luk6xff/led-clock/README.md

# led-clock
LED clock with some fancy features.

## Details
The clock is configurable over web inteface. The time is provided by extremaly accurate RTC DS3231. It can be also synchronized with NTP server.
It receives and display meteo data from external LORA sensor.
You can also configure [openweather map API](https://openweathermap.org/) to get and display latest weather forecast for your city.
The clock UI supports two languages currently: polish and english.
You can check below the videos to see how it works in action:

* video1 (https://www.youtube.com/watch?v=KoFvoKO0Jg0)
* video1 (https://www.youtube.com/watch?v=WqVvntWIiOE)

## Some pics
### Device
* Printed Case:
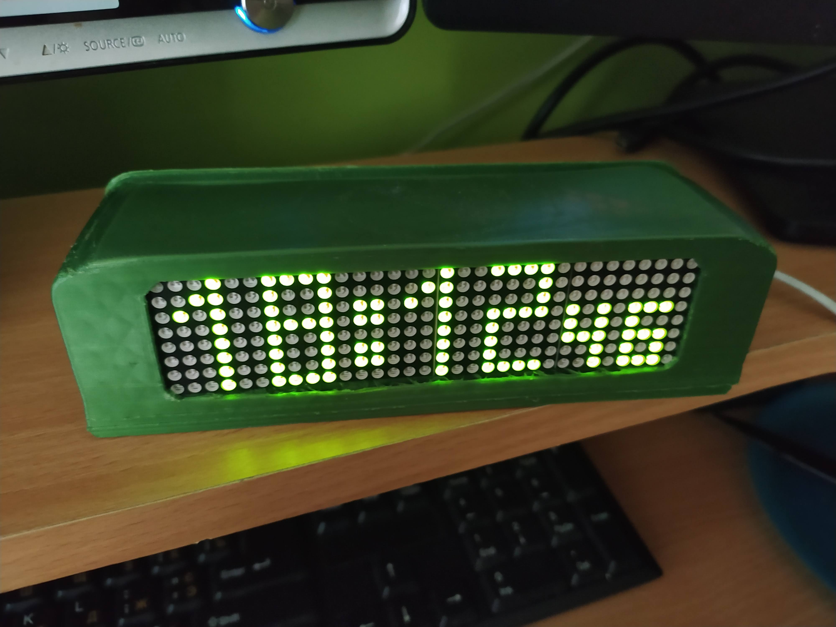
[picture p1: docs/pics/dev-case1.jpg]

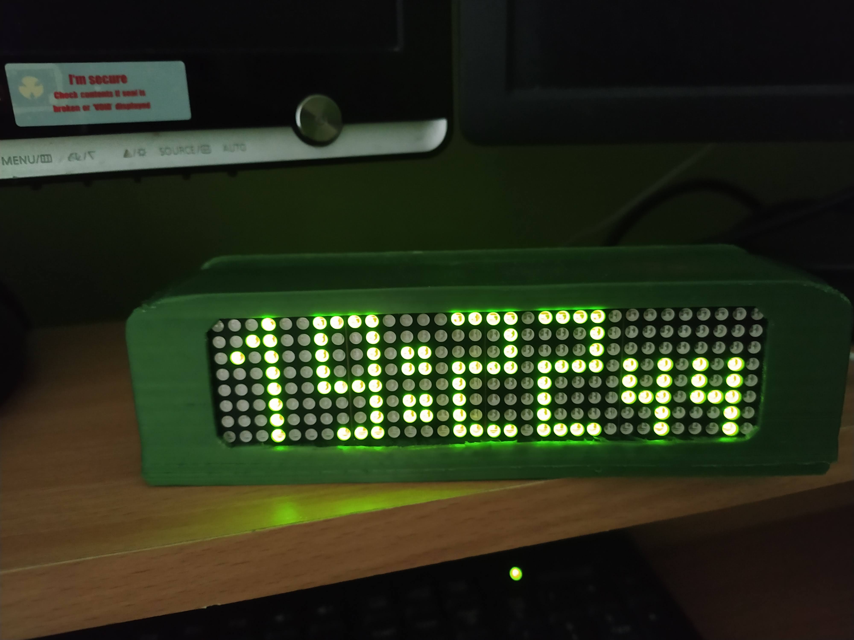
[picture p2: docs/pics/dev-case2.jpg]

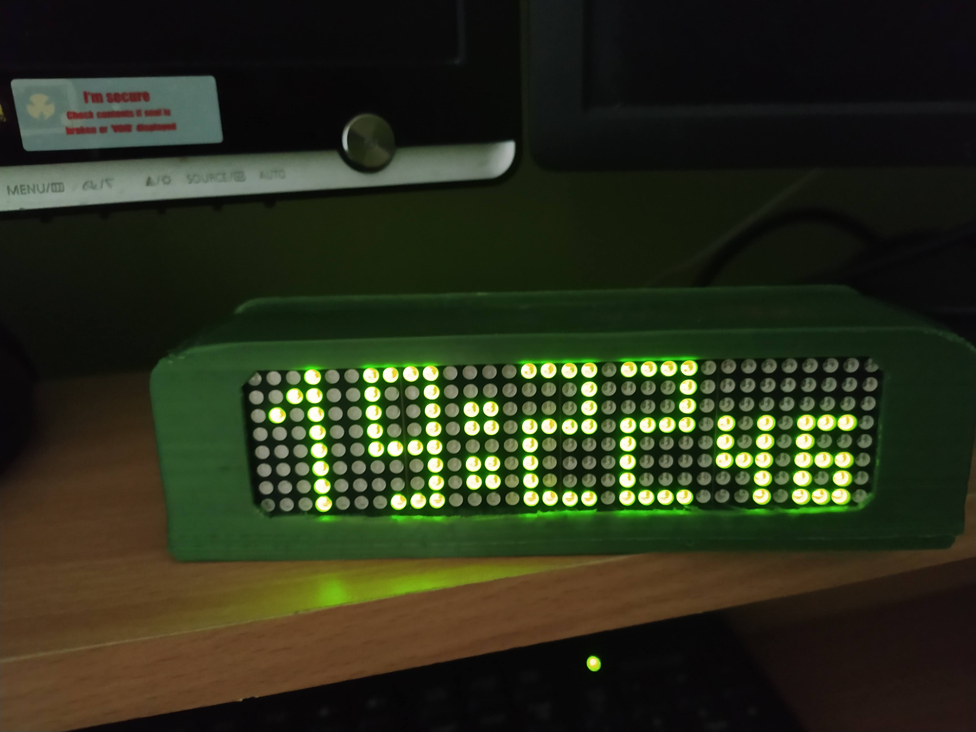
[picture p3: docs/pics/dev-case3.jpg]

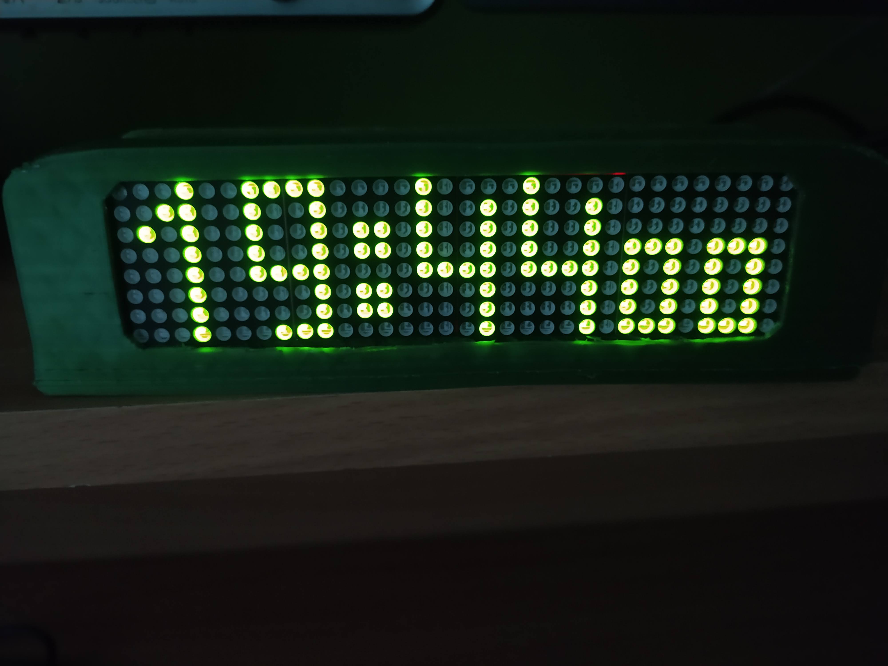
[picture p4: docs/pics/dev-case4.jpg]


* LoRa meteo sensor:

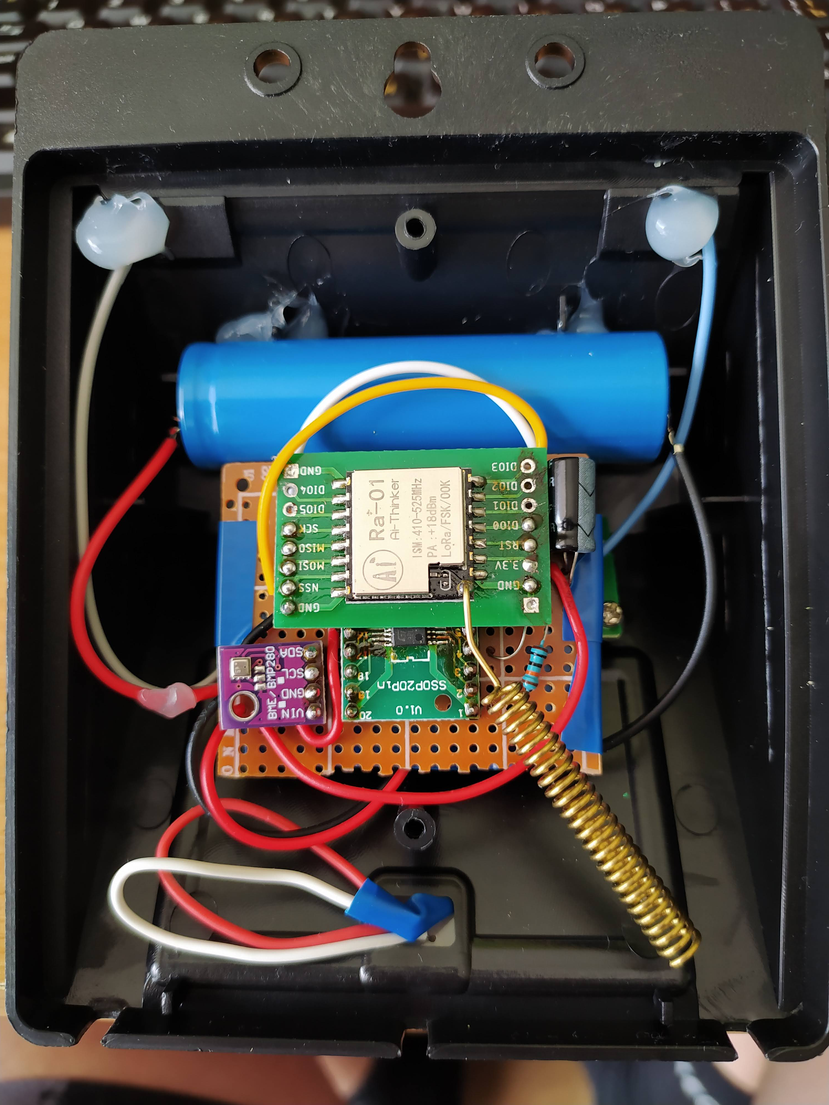
[picture p6: docs/pics/dev-sensor12.jpg]

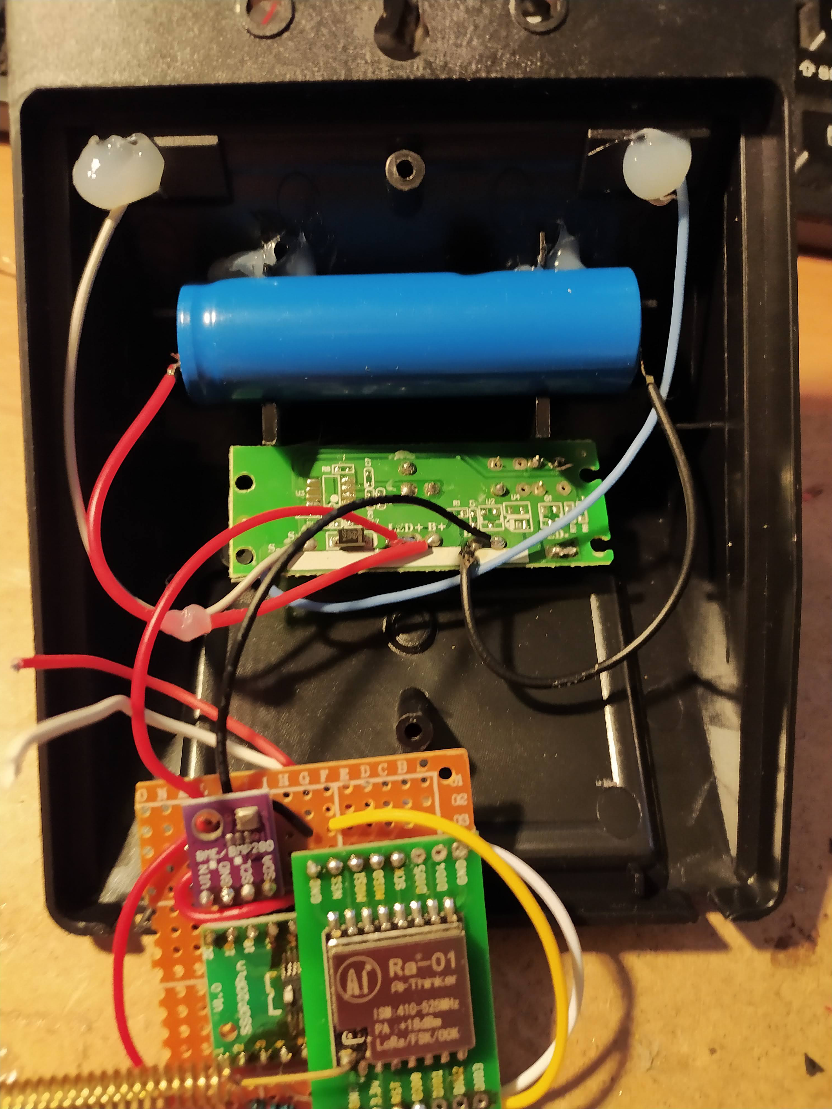
[picture p7: docs/pics/dev-sensor11.jpg]

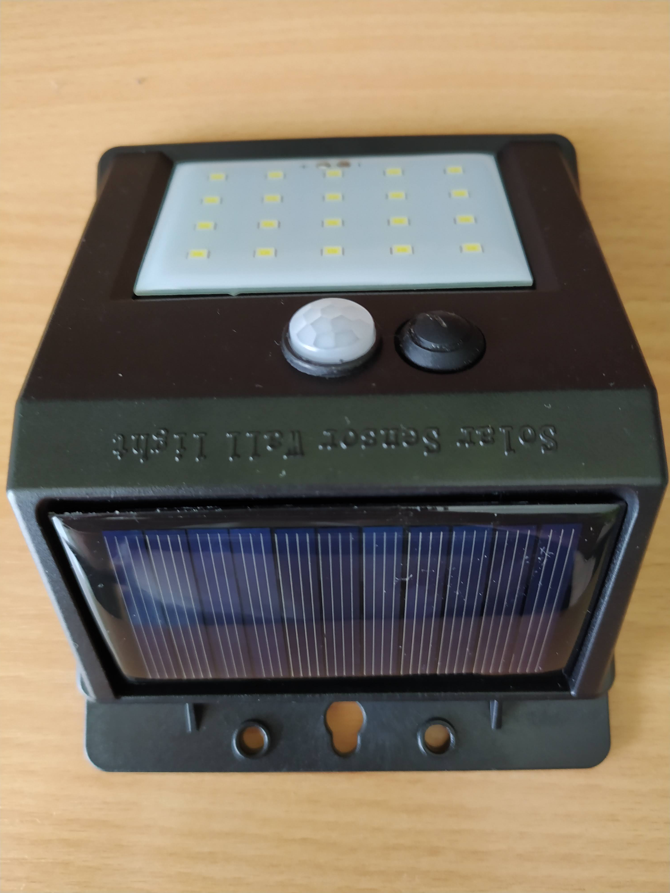
[picture p8: docs/pics/dev-sensor15.jpg]


* Custom Case:
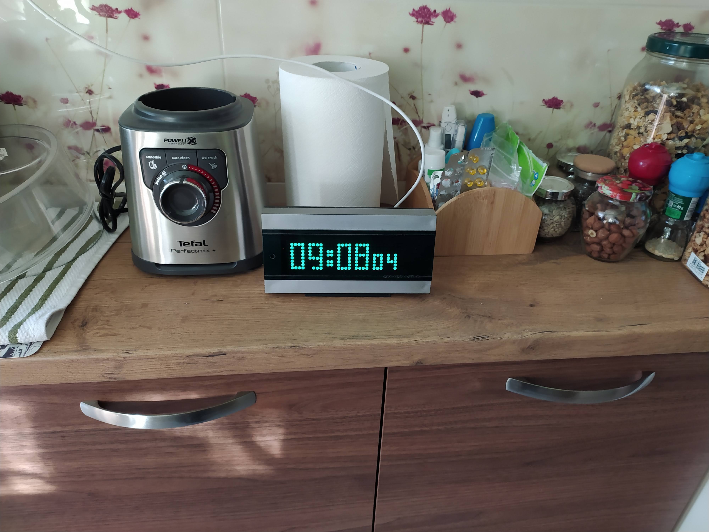
[picture p9: docs/pics/dev-custom-case1.jpg]

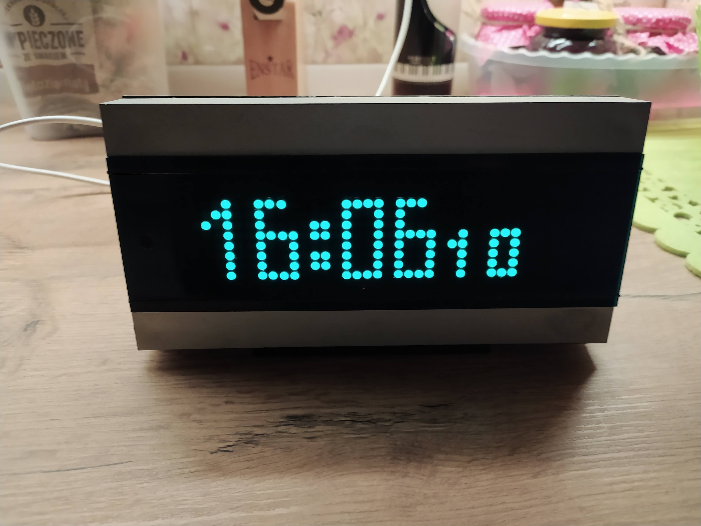
[picture p10: docs/pics/dev-custom-case2.jpg]

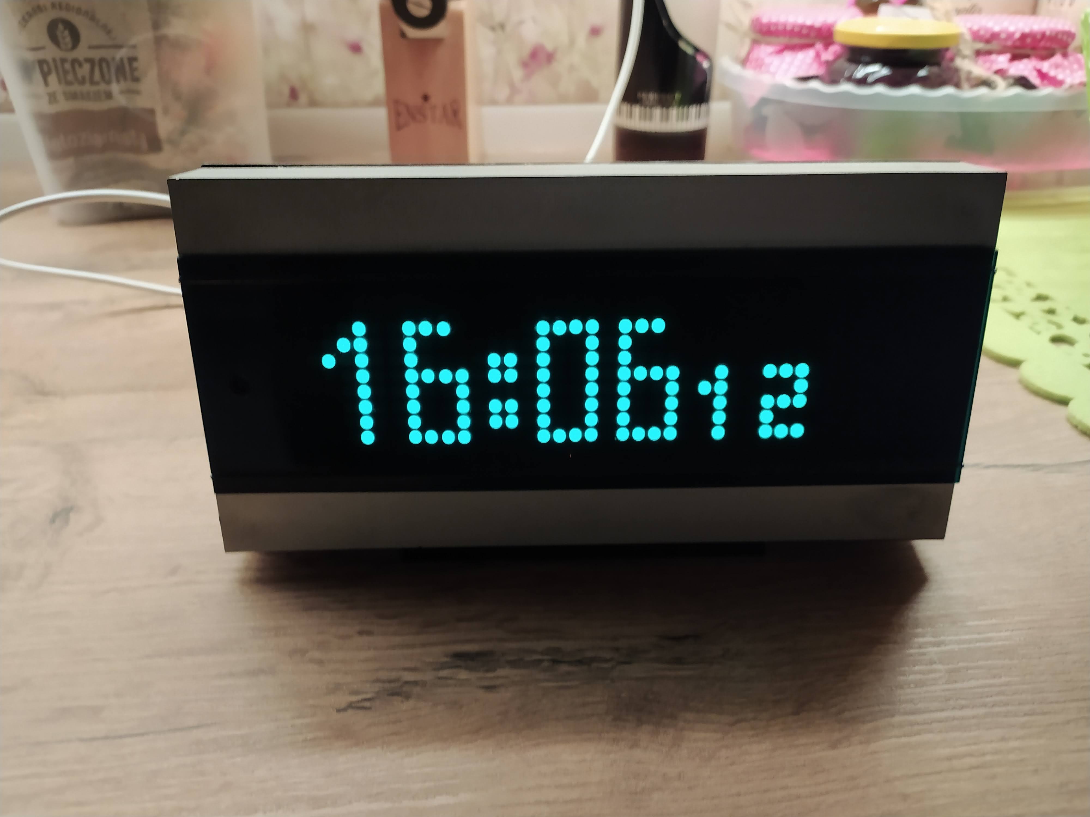
[picture p11: docs/pics/dev-custom-case3.jpg]


* Prototype:
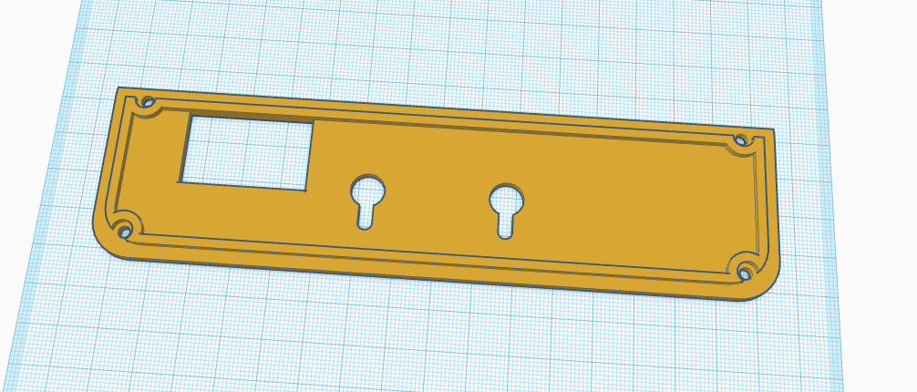
[picture p12: case/images/back.png]

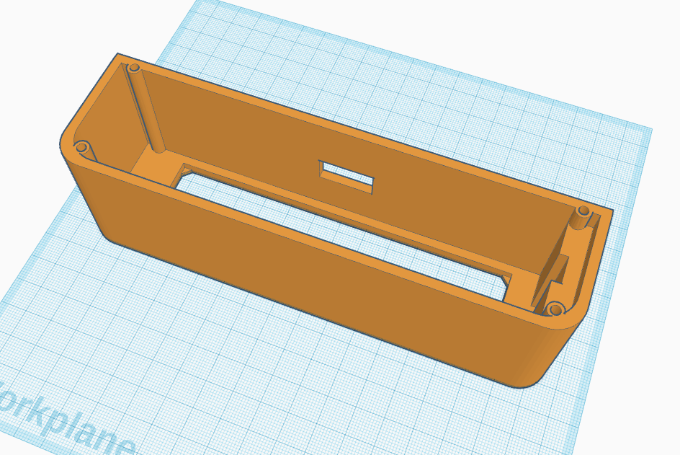
[picture p13: case/images/front1.png]

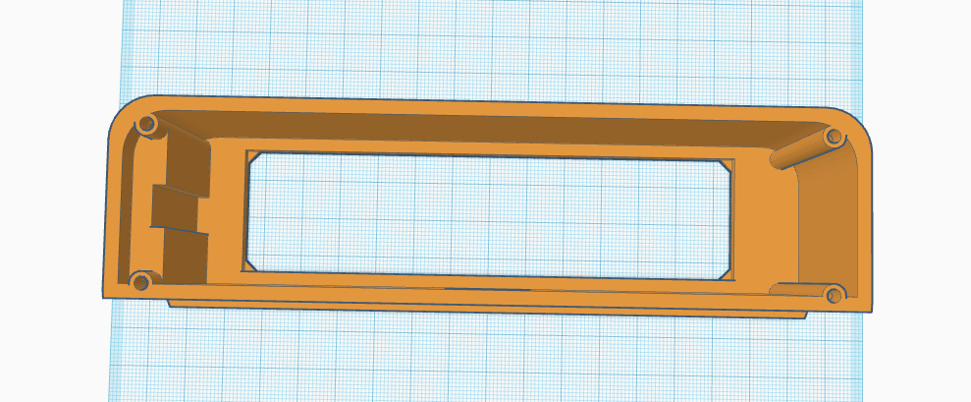
[picture p14: case/images/front2.png]

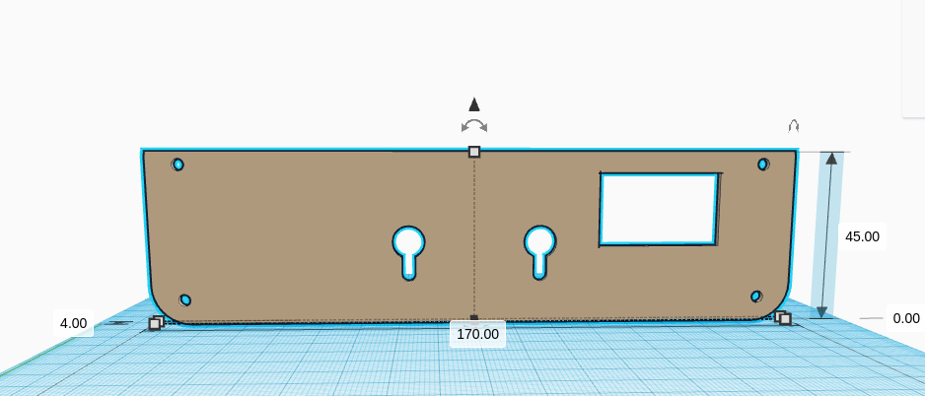
[picture p15: case/images/back_1.png]

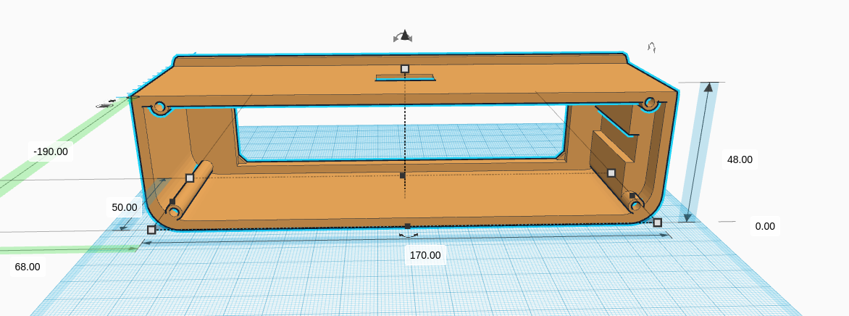
[picture p16: case/images/front_1.png]

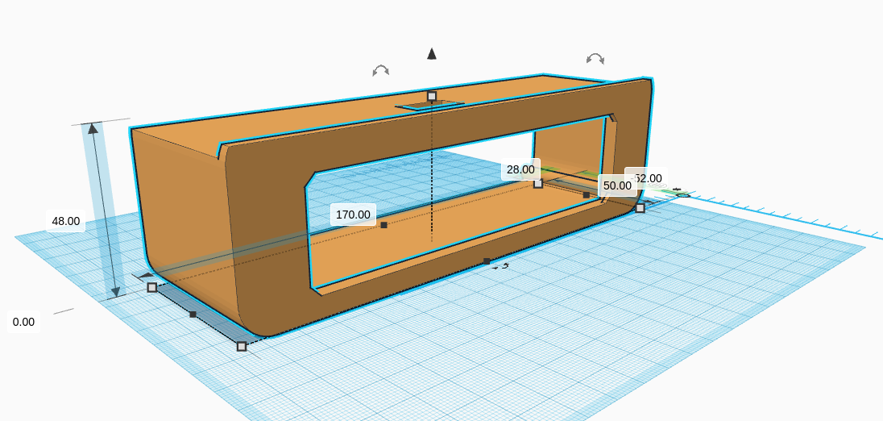
[picture p17: case/images/front_2.png]

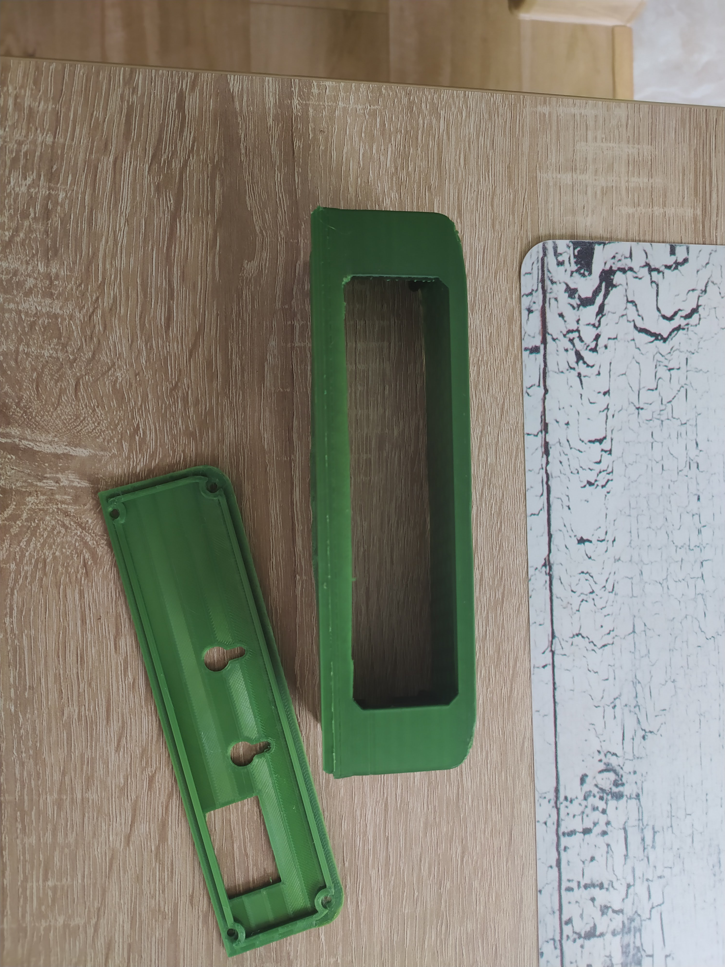
[picture p18: docs/pics/dev-case-raw1.jpg]

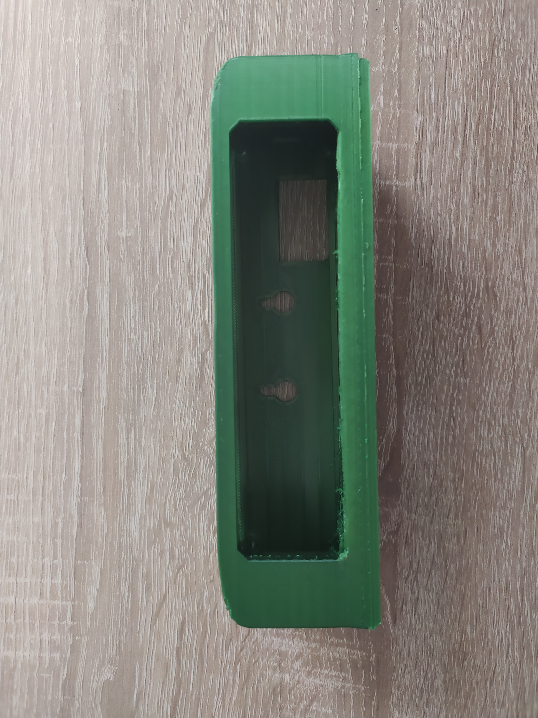
[picture p19: docs/pics/dev-case-raw2.jpg]

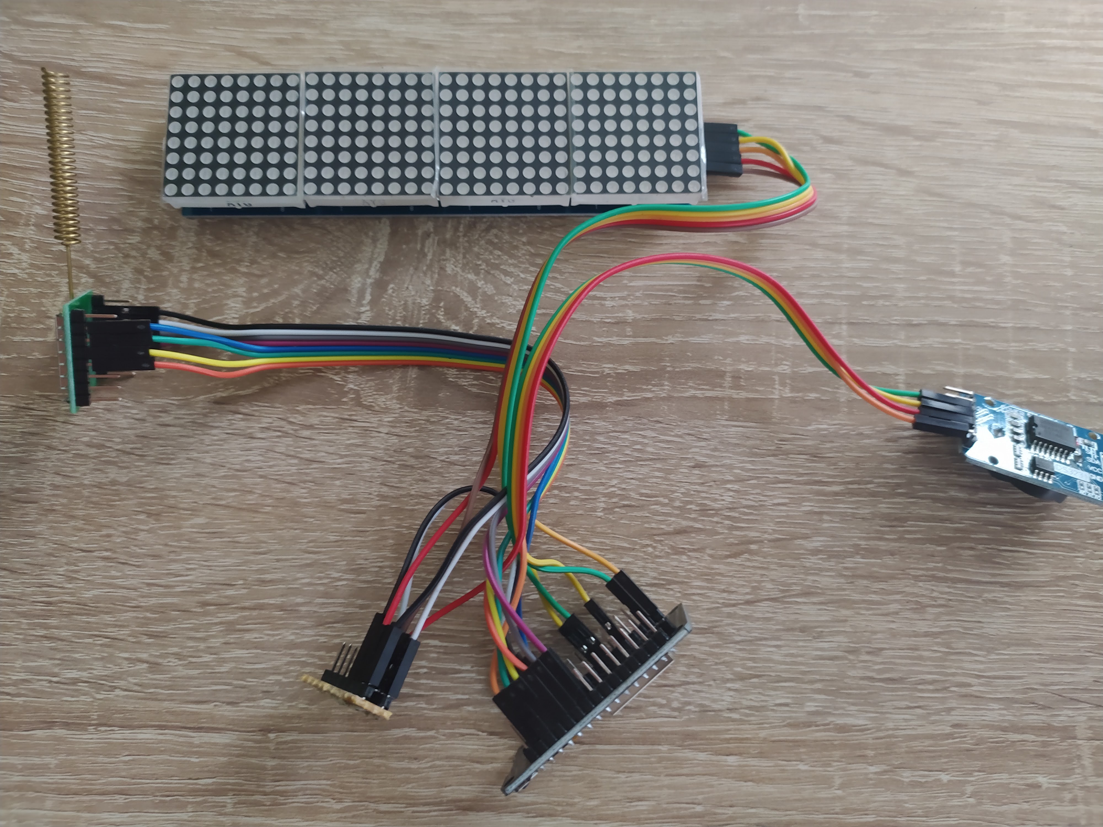
[picture p20: docs/pics/dev-prototype.jpg]


### Web app
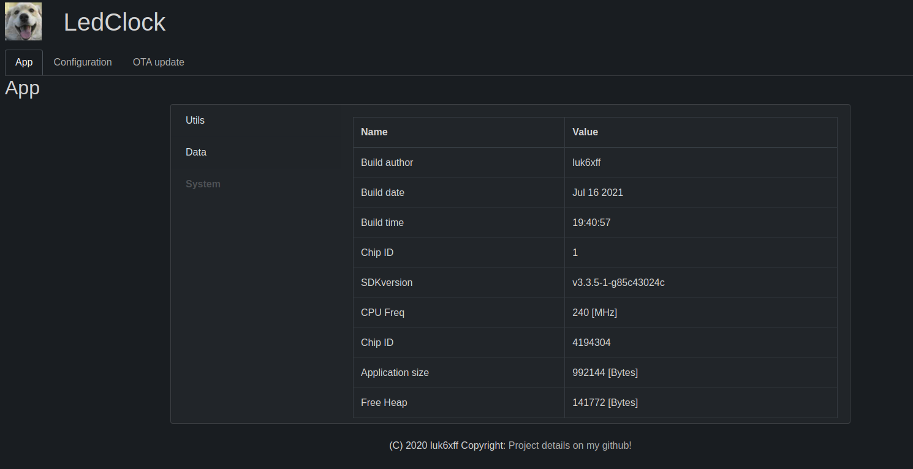
[picture p21: docs/pics/web-app-info-ui.png]

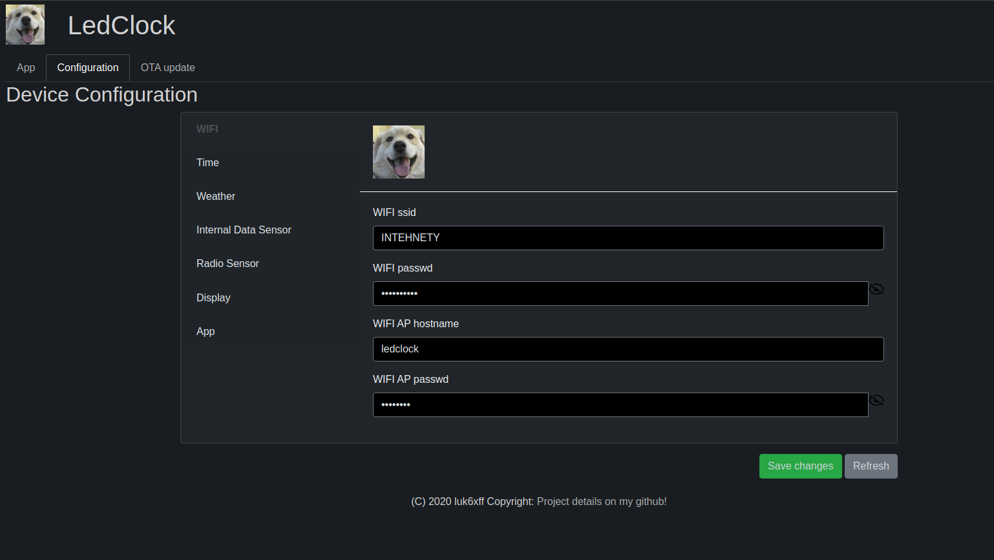
[picture p22: docs/pics/web-config-ui.png]

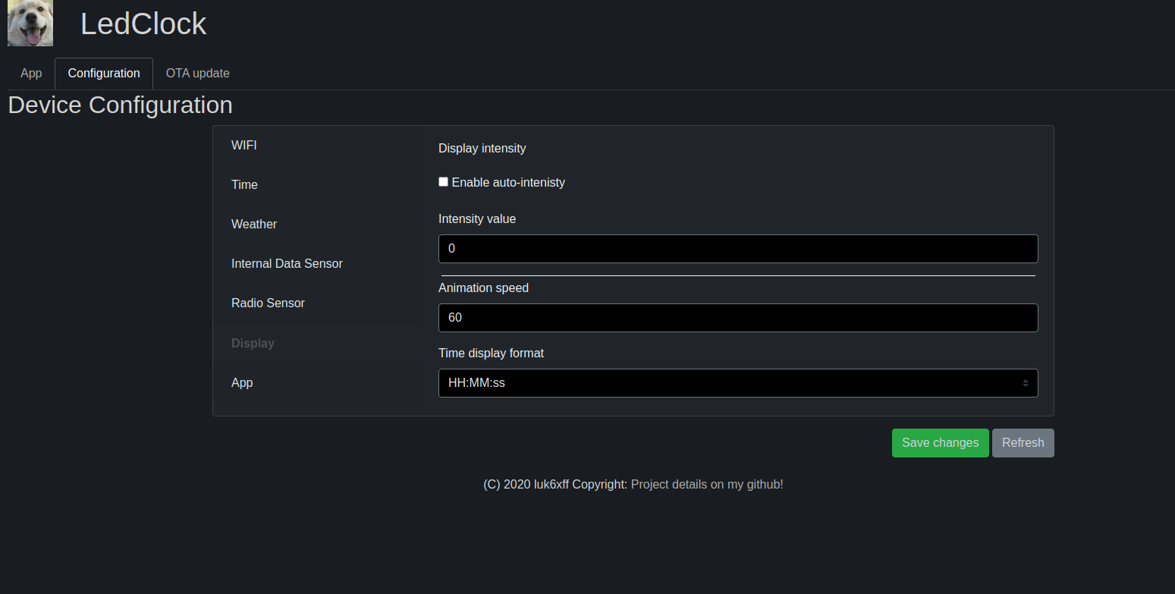
[picture p23: docs/pics/web-config-ui2.png]

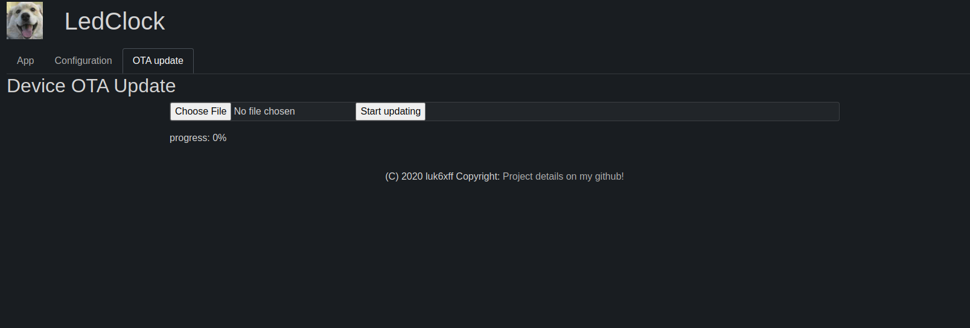
[picture p24: docs/pics/web-ota-ui.png]

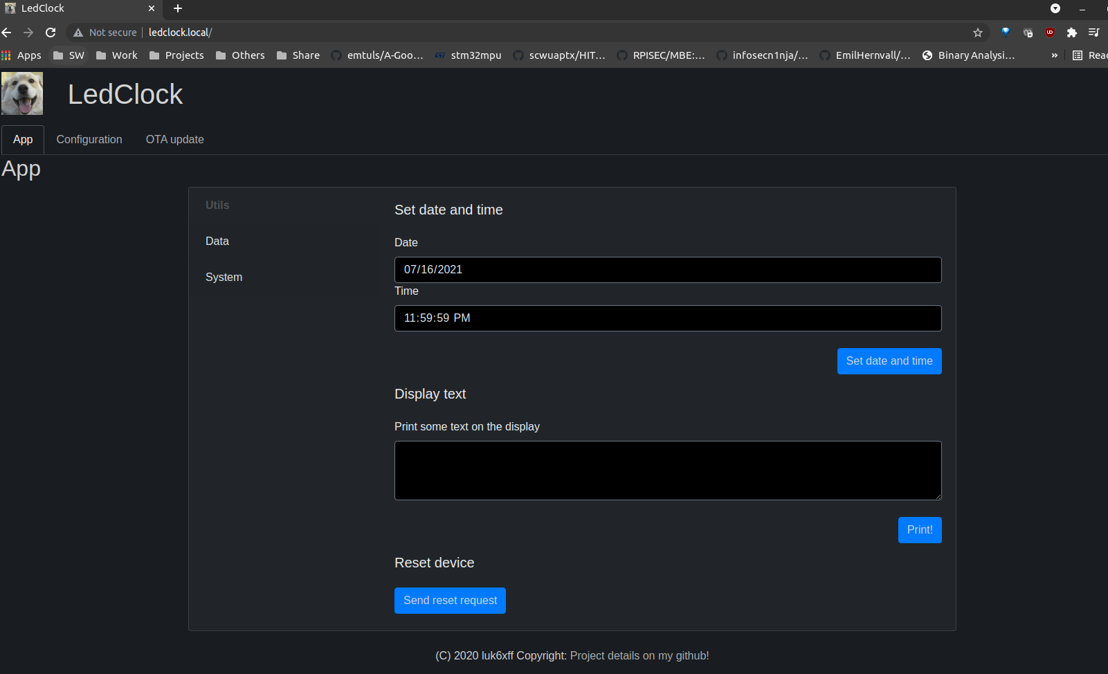
[picture p25: docs/pics/web-ui.png]


### Schematics
* Clock:
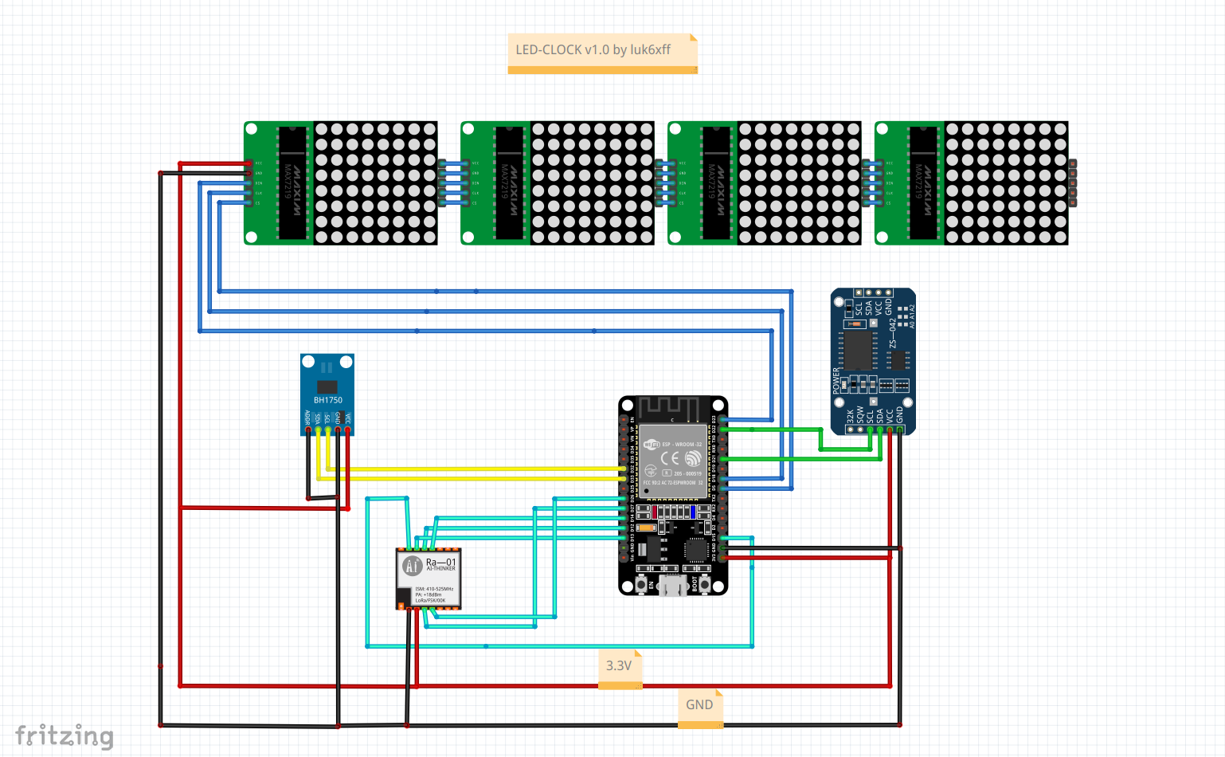
[picture p26: docs/schematics/clock/led-clock_schematic.png]

* LoRa external sensor:
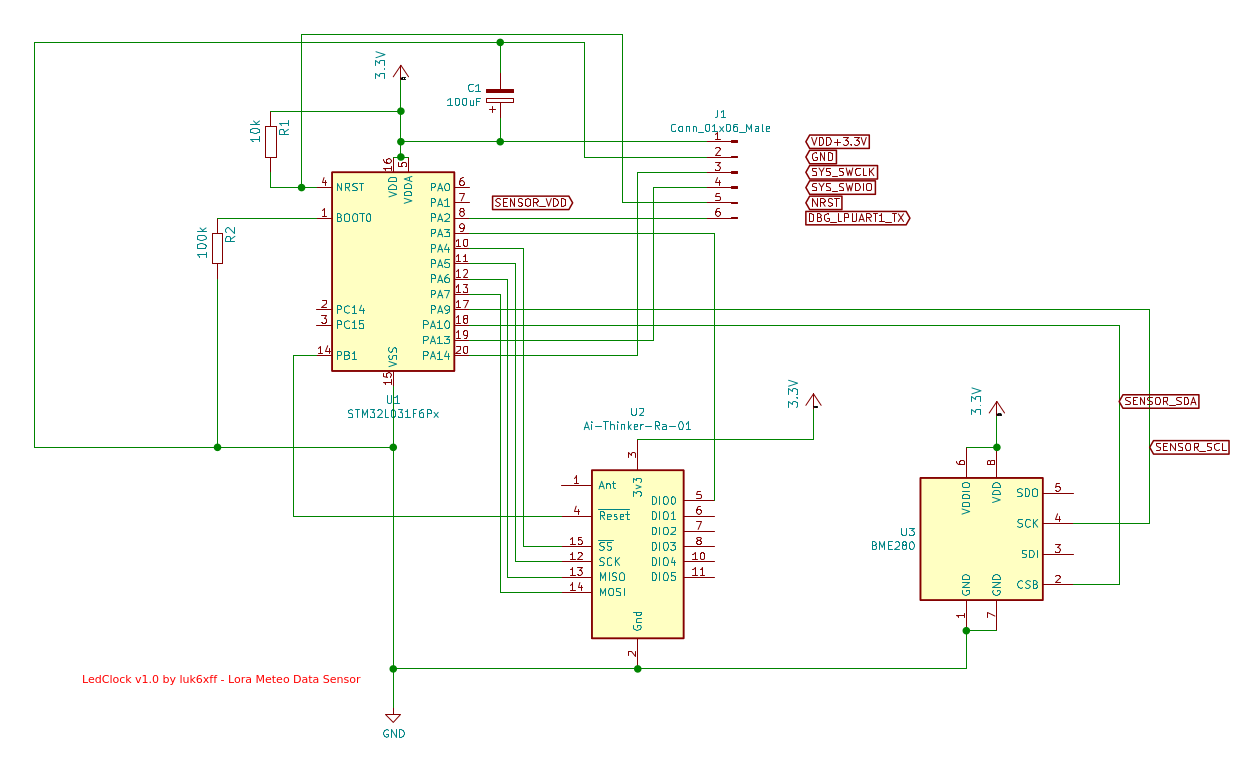
[picture p27: docs/schematics/sensor/ledclock-sensor_schematic.png]


## Parts used
All the modules used in the project are listed [here](./docs/BOM.md).

## The project contains of 2 subprojects:

### [esp32-app](./esp32-app/README.md)
Main clock application based on esp32 wroom device. README here: [esp32-app-readme](./esp32-app/README.md)

### [sensor-app](./sensor-app/README.md)
Sensor board application based on STM32L031F6Px. README here: [sensor-app-readme](./sensor-app/README.md)
