luk6xff/led-clock/docs/pics/dev-custom-case.jpg

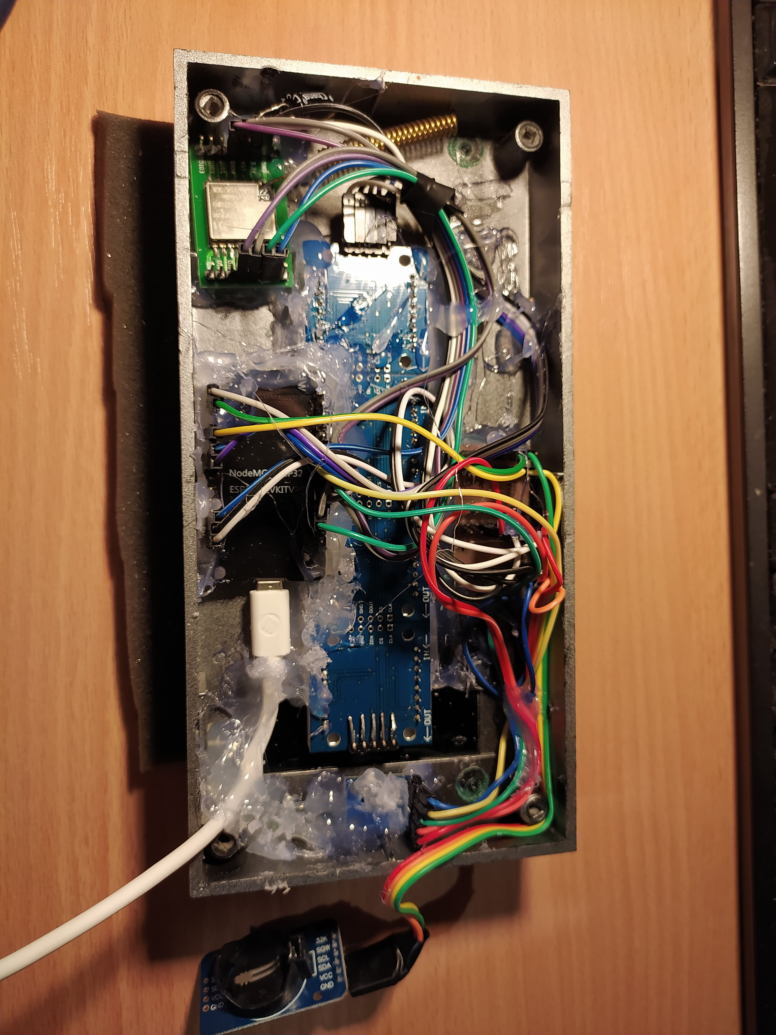
docs/pics/dev-custom-case.jpg
