luk6xff/led-clock/docs/pics/dev-sensor2.jpg

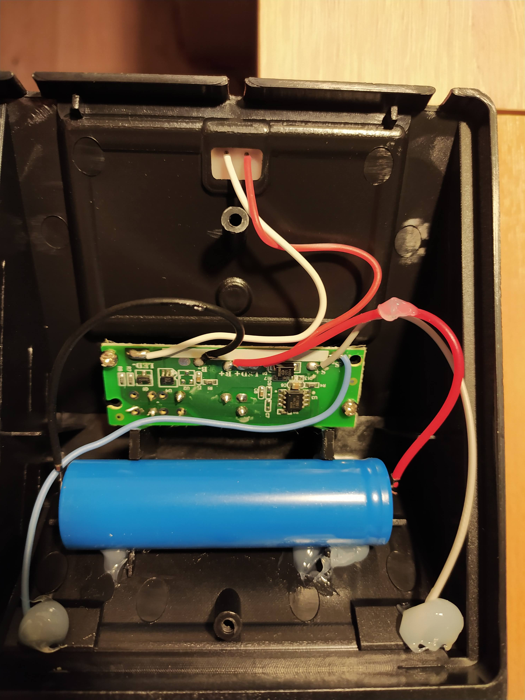
docs/pics/dev-sensor2.jpg
