luk6xff/led-clock/docs/pics/dev-sensor3.jpg

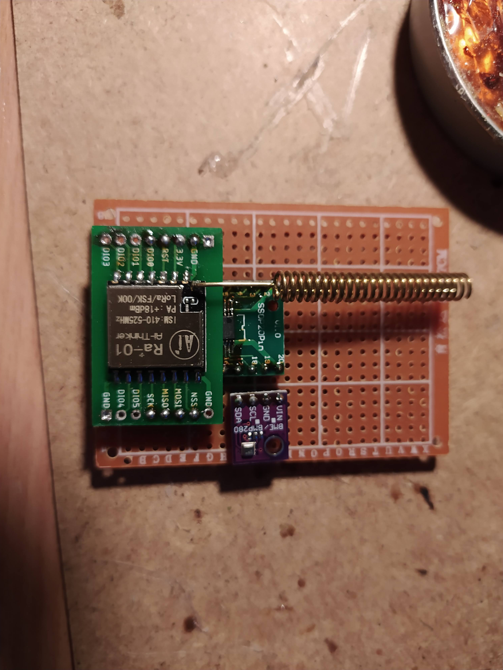
docs/pics/dev-sensor3.jpg
