luk6xff/led-clock/docs/pics/dev-sensor4.jpg

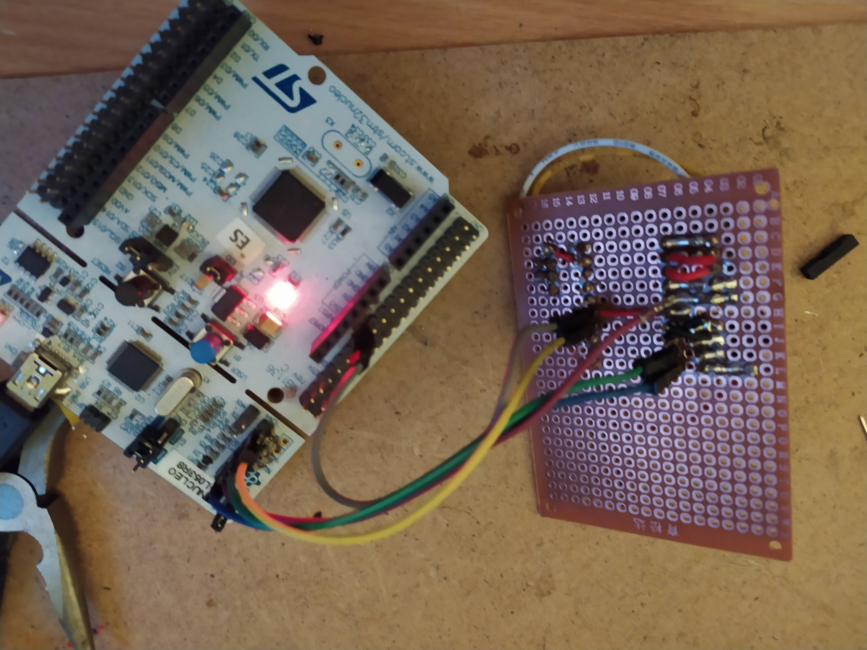
docs/pics/dev-sensor4.jpg
