luk6xff/led-clock/docs/pics/dev-sensor8.jpg

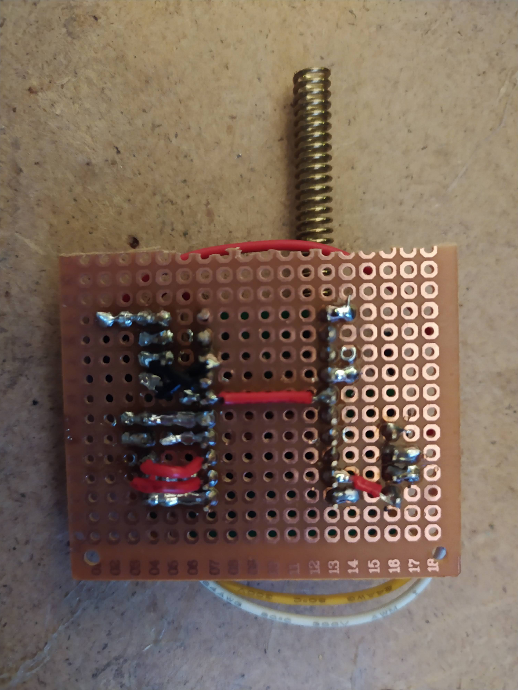
docs/pics/dev-sensor8.jpg
