luk6xff/led-clock/docs/pics/dev-sensor9.jpg

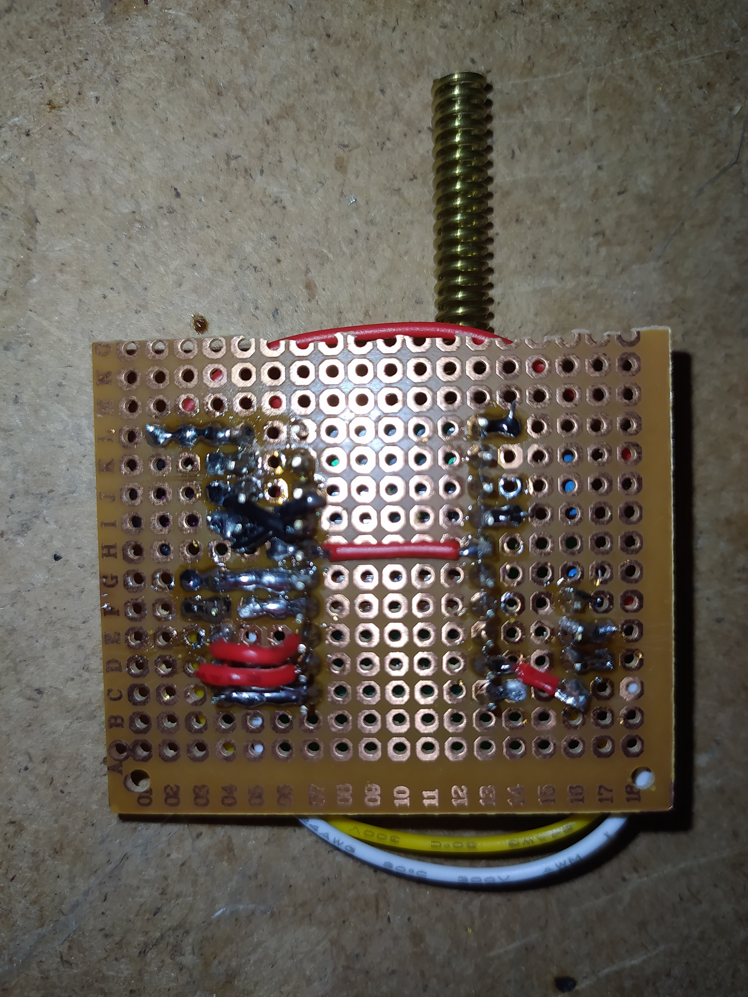
docs/pics/dev-sensor9.jpg
