luk6xff/led-clock/docs/pics/dev-sensor10.jpg

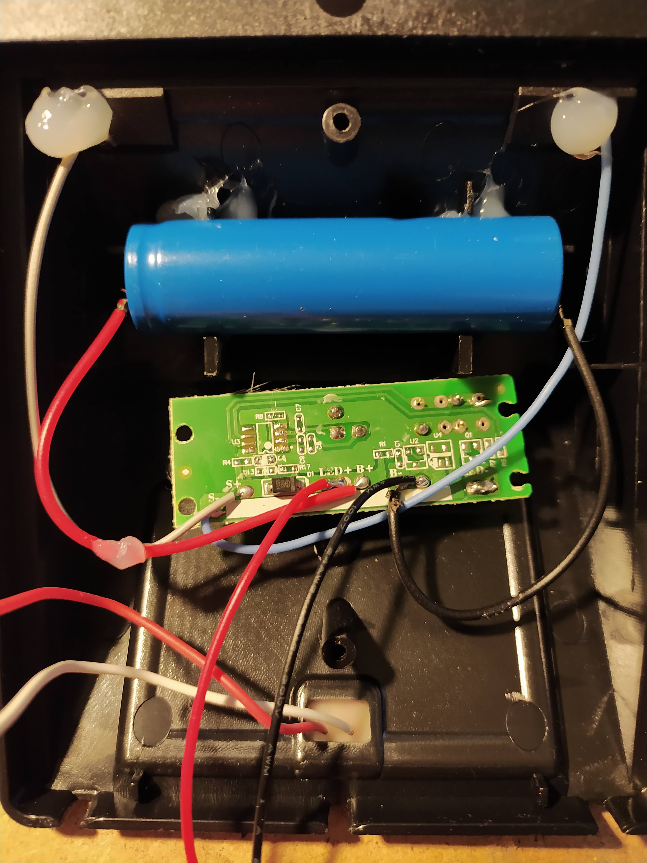
docs/pics/dev-sensor10.jpg
