luk6xff/led-clock/docs/pics/dev-sensor13.jpg

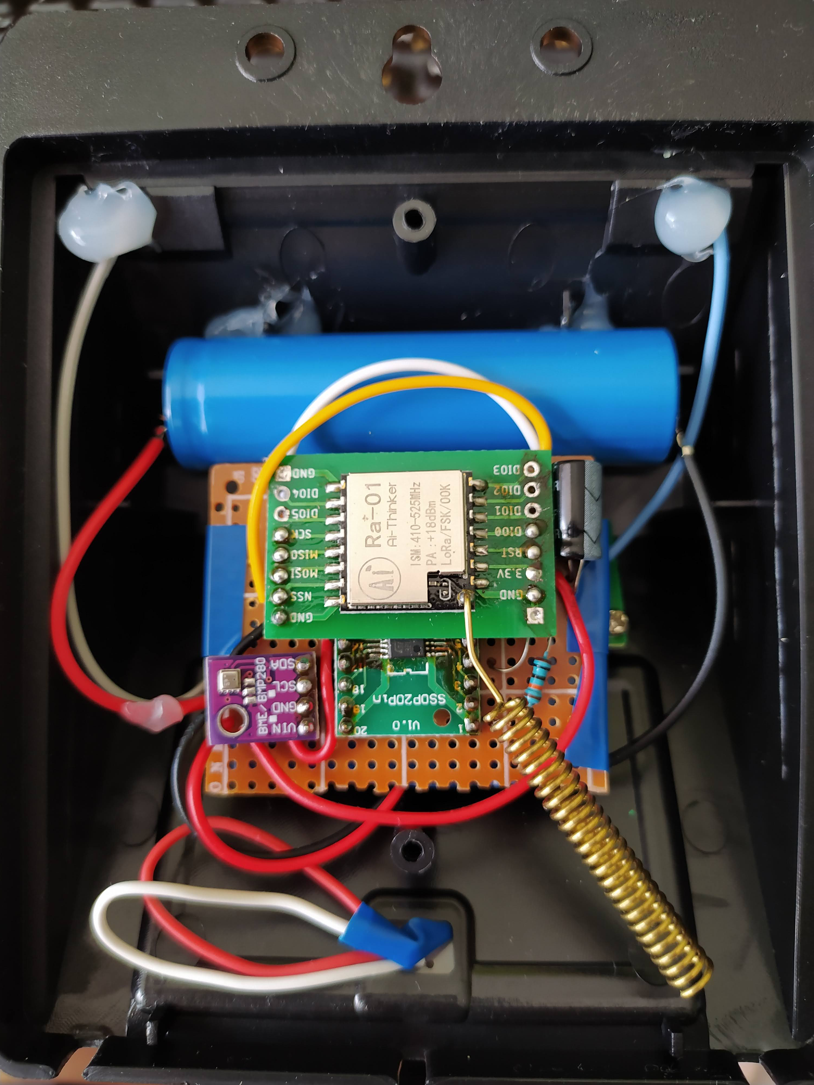
docs/pics/dev-sensor13.jpg
