luk6xff/led-clock/docs/pics/dev-sensor14.jpg

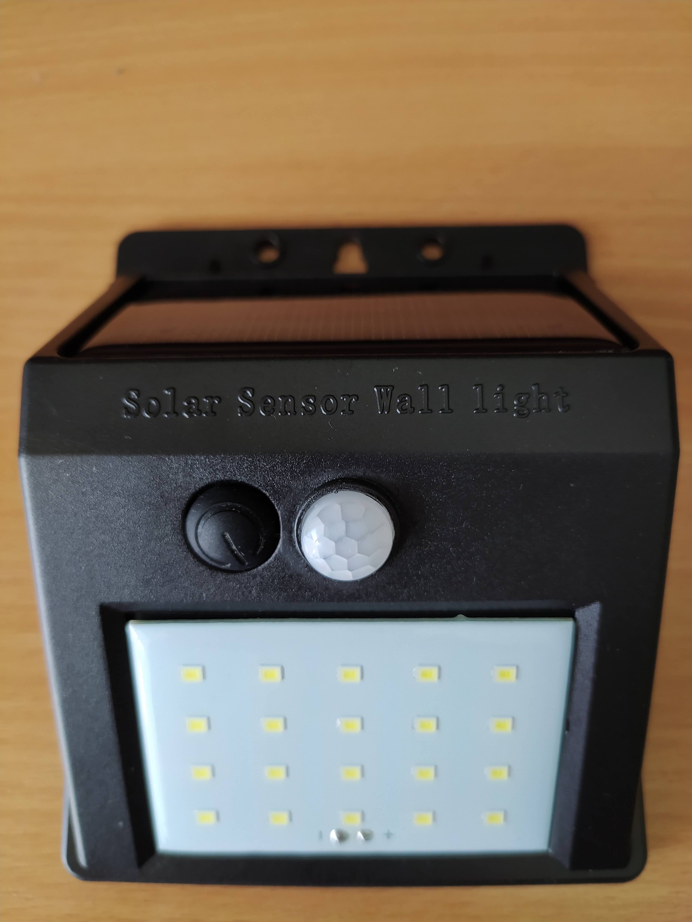
docs/pics/dev-sensor14.jpg
