luk6xff/led-clock/docs/pics/dev-sensor.jpg

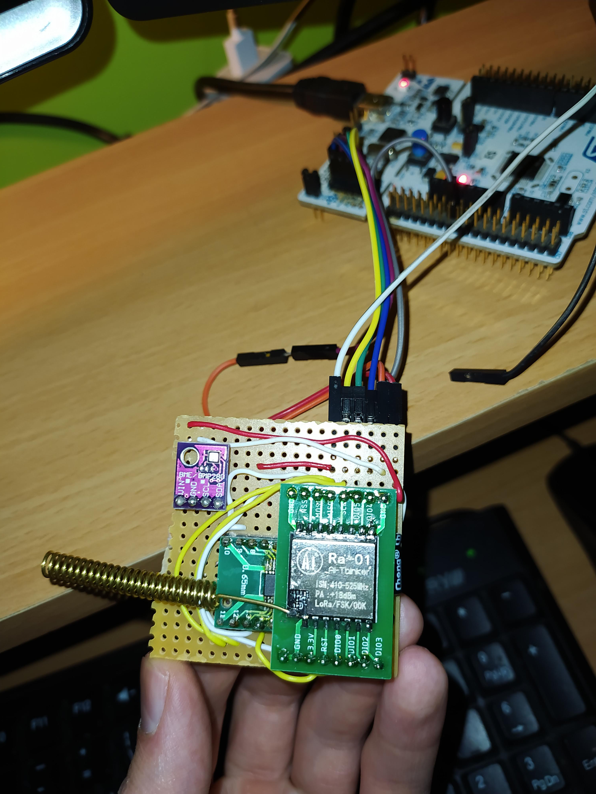
docs/pics/dev-sensor.jpg
