luk6xff/led-clock/docs/BOM.md

# LED-CLOCK PROJECT BOM

## CLOCK
| PART NAME | SHOP LINK | DATASHEET | QUANTITY | PRICE [PLN] |
|---|---|---|---|---|
| ESP-32 ESP-WROOM-32D Bluetooth/WIFI | [AliExpress](https://aliexpress.com/item/33048658274.html)| [ESP-WROOM-32D](./docs/datasheet/esp32-wroom-32d_datasheet_en.pdf) | 1 | 15.00 |
| LED 4 MATRIX 32x8-MAX7219 | [AliExpress](https://aliexpress.com/item/4000138443792.html) | [MAX7219](./docs/datasheet/MAX7219.pdf) | 1 | 15.80 |
| RTC-DS3231 | [AliExpress](https://aliexpress.com/item/4000155557490.html) | [DS3231](./docs/datasheet/DS3231.pdf) | 1 | 9.80 |
| BH1750FVI Ambient light sensor | [AliExpress](https://aliexpress.com/item/1005002652352319.html) | [BH1750](./docs/datasheet/Z23.pdf) | 1 | 3.70 |
| RA-01 - SX1278 LoRa radio | [AliExpress](https://aliexpress.com/item/32809772660.html) | [RA-01](./docs/datasheet/SX1276_77_78_79.pdf) | 1 | 11.50 |
|  |  |  |  | = 55.80 (~15.00 USD) |

## SENSOR
| PART NAME | SHOP LINK | DATASHEET | QUANTITY | PRICE [PLN] |
|---|---|---|---|---|
| STM32L031F6P6 | [AliExpress](https://pl.aliexpress.com/item/1005002889155343.html) | [STM32L031F6Px](docs/datasheet/STM32L031F6.pdf) | 1 | 14.13 |
| BME280 Sensor | [AliExpress](https://aliexpress.com/item/1005002436807168.html)|[BME-280](./docs/datasheet/BME280.pdf) | 1 | 5.60 |
| RA-01 - SX1278 LoRa radio | [AliExpress](https://aliexpress.com/item/32809772660.html) | [RA-01](./docs/datasheet/SX1276_77_78_79.pdf) | 1 | 11.50 |
|  |  |  |  | = 31.23 (~8.00 USD)
