luk6xff/led-clock/case/files/LedClock-Front.stl

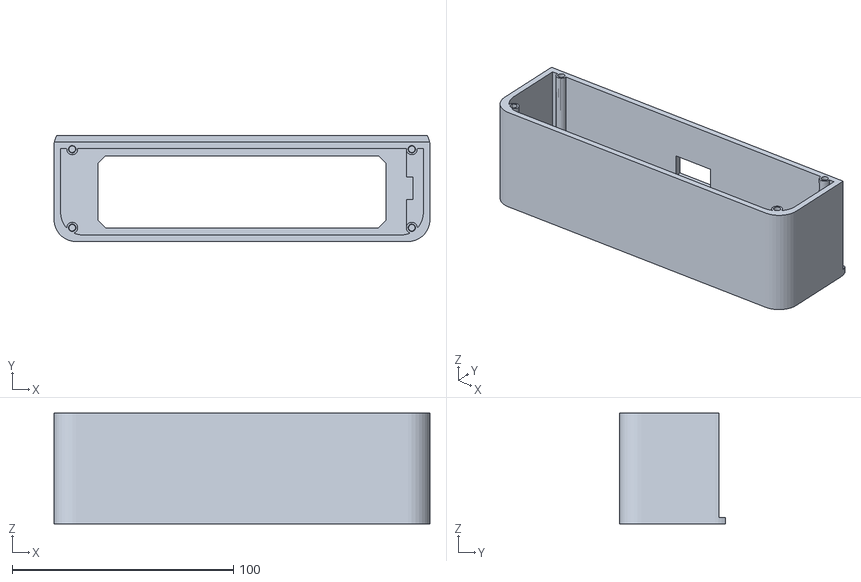
[picture p40: CAD file, 2021-07-14]
case/files/LedClock-Front.stl
170.0 x 48.0 x 50.0
