luk6xff/led-clock/case/files/LedClock-Back.stl

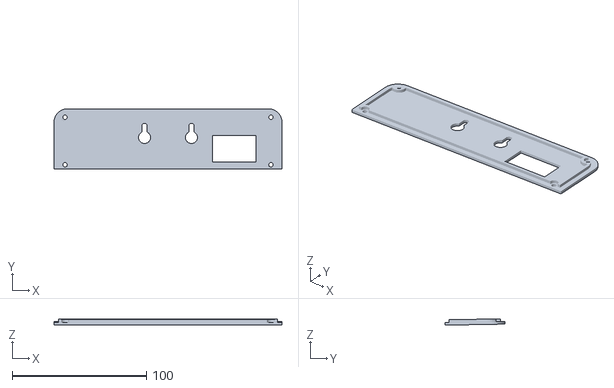
[picture p41: CAD file, 2021-07-14]
case/files/LedClock-Back.stl
170.0 x 45.0 x 4.73
