luk6xff/led-clock/esp32-app/utils/WebServerTestApp/README.md

# LED-CLOCK WEBSERVER Test App

## Instalation
```
$ npm install express --save
$ npm install compression --save
```

## Run App
```
$ node server.js
```
