luk6xff/led-clock/esp32-app/utils/ArduinoJsonTestApp/README.md

# LED-CLOCK ArduinJson Library Test App

## Build and run the App
```
$ make clean all && ./build/apps/app
```
