luk6xff/led-clock/docs/schematics/sensor/ledclock-sensor.pdf

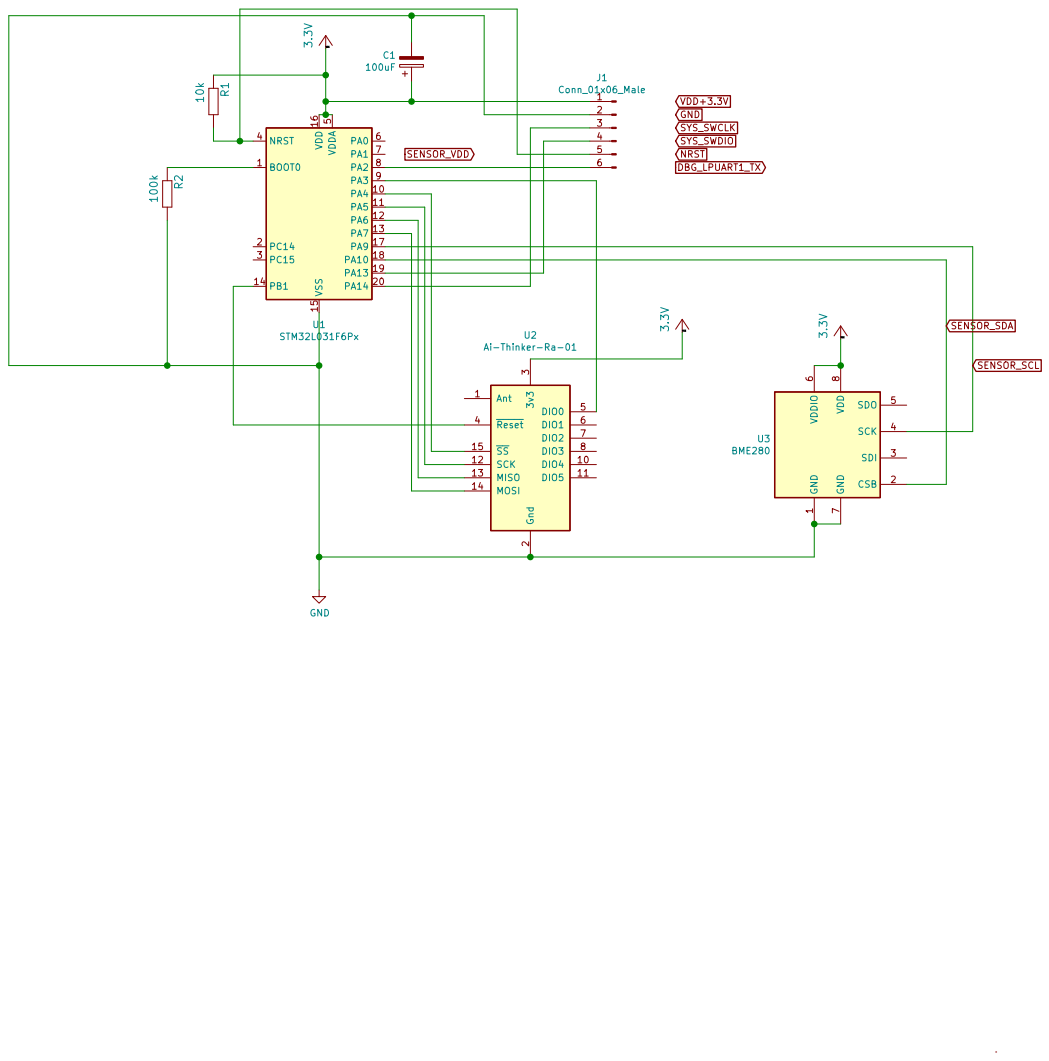
[picture p42: page 1]

3.3V 3.3V 3.3V GND 1 CSB 2 SDI 3 SCK 4 SDO 5 VDDIO 6 GND 7 VDD 8 U3 BME280 R2 100k Ant 1 DIO4 10 DIO5 11 SCK 12 MISO 13 MOSI 14 SS 15 Gnd 2 3v3 3 Reset 4 DIO0 5 DIO1 6 DIO2 7 DIO3 8 U2 Ai-Thinker-Ra-01 C1
