luk6xff/led-clock/(list of files, drawings)

Other design files:
docs/schematics/clock/led-clock.fzz
