luk6xff/led-clock/docs/schematics/sensor/ledclock-sensor.kicad_pcb

## KiCad design docs/schematics/sensor/ledclock-sensor.kicad_pcb (2020-12-05)

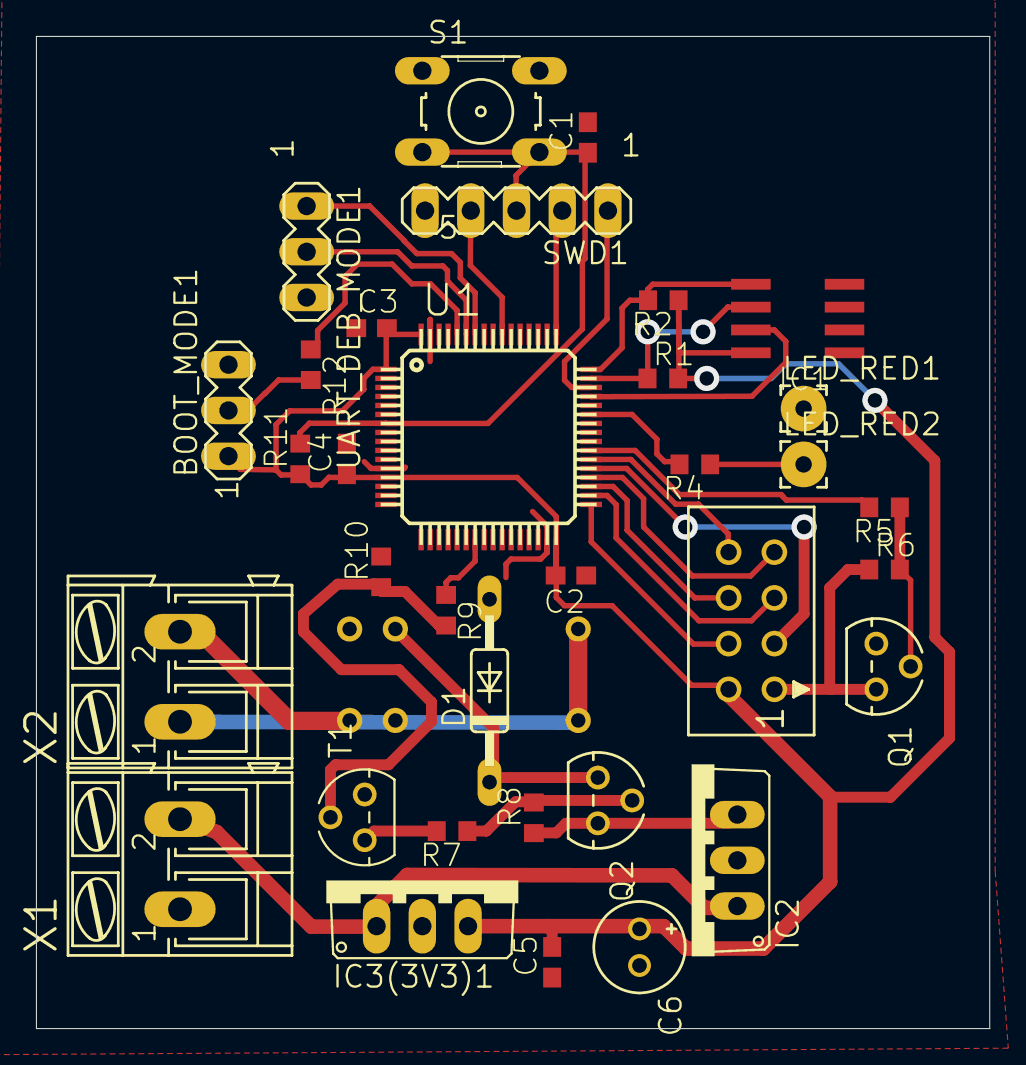
[picture p43: board ledclock-sensor.kicad_pcb from above]

Board: 2 copper layers, 53.0 x 55.1 mm, 35 parts (0 on the bottom side), 33 nets.

Parts:
BOOT_MODE1: MA03-1
C1, C2, C3, C5: 100nF; C0603
C4: 10nF; C0603
C6: CPOL-EUE2-5; E2-5
CON1: CON10
D1: 1N4148DO35-10; DO35-10
IC1: 24SN; SO-08
IC2, IC3(3V3)1: 78TV; TO220V
LED_RED1, LED_RED2: 2,54_0,9
Q1, Q2: BC557; TO92
R1, R2, R4: 4.7k; R0603
R5, R7, R9: 5.1k; R0603
R6, R8, R10: 10k; R0603
R11, R12: 100k; R0603
S1: 10-XX; B3F-10XX
SWD1: MA05-1
T1: BC547; TO92
U1: STM32F10XRXT6; TQFP64
U$1: PRZEKAZ; FPR
UART_DEB_MODE1: MA03-1
X1, X2: AK300_2

Connections:
+5V: IC2.3, Q2.1, R8.1
+24V: IC2.1, IC3(3V3)1.1, X1.2
/CE: CON1.3, U1.37
/IRQ: CON1.8, U1.38
/MISO: CON1.7, U1.36
/NRST: C1.1, R11.2, S1.3, S1.4, SWD1.3, U1.7
/RX: U1.59, UART_DEB_MODE1.2
/SCK: CON1.5, U1.34
/SWCLK: SWD1.2, U1.49
/SWDIO: SWD1.1, U1.46
/SWO: SWD1.4, U1.55
/TX: U1.58, UART_DEB_MODE1.1
GND: BOOT_MODE1.3, C1.2, C2.1, C3.1, C4.2, C5.1, C6.-, D1.A, IC1.1, IC1.2, IC1.3, IC1.4, IC2.2, IC3(3V3)1.2, LED_RED1.1, Q1.3, R10.2, S1.1, S1.2, SWD1.5, T1.1, U1.12, U1.31, U1.63, U$1.P$4, UART_DEB_MODE1.3, X1.1
unnamed: BOOT_MODE1.2, R12.2
unnamed: CON1.1, Q1.1, R6.1
unnamed: CON1.4, U1.33
unnamed: CON1.6, U1.35
unnamed: D1.C, Q2.3, U$1.P$3
unnamed: IC1.5, R2.2, U1.48
unnamed: IC1.6, R1.1, U1.47
unnamed: IC1.7, U1.45
unnamed: LED_RED2.1, R4.1
unnamed: Q1.2, R5.1, R6.2
unnamed: Q2.2, R7.1, R8.2
unnamed: R4.2, U1.43
unnamed: R5.2, U1.39
unnamed: R7.2, T1.3
unnamed: R9.1, U1.23
unnamed: R9.2, R10.1, T1.2
unnamed: R12.1, U1.60
unnamed: U$1.P$1, U$1.P$2, X2.1
unnamed: U$1.P$6, X2.2
VCC: BOOT_MODE1.1, C2.2, C3.2, C4.1, C5.2, C6.+, CON1.2, IC1.8, IC3(3V3)1.3, R1.2, R2.1, R11.1, U1.1, U1.13, U1.32, U1.64
