luk6xff/led-clock/sensor-app/Core/Src/main.c

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

/* Includes ------------------------------------------------------------------*/
#include "main.h"

/* USER CODE BEGIN Includes */
#include "settings.h"
#include "radio.h"
#include "sensor.h"
/* USER CODE END Includes */


I2C_HandleTypeDef hi2c1;

UART_HandleTypeDef hlpuart1;

RTC_HandleTypeDef hrtc;

SPI_HandleTypeDef hspi1;

WWDG_HandleTypeDef hwwdg;

/* USER CODE BEGIN PV */
char dbg_buf[32];
void dbg(const char *msg)
{
	/* Place your implementation of fputc here */
	uint16_t len = strlen(msg);
	uint8_t buf[len+2];
	memcpy(buf, msg, len);
	buf[len] = '\r';
	buf[len+1] = '\n';
	HAL_UART_Transmit(&hlpuart1, buf, len+2, 500);
}
/* USER CODE END PV */

void SystemClock_Config(void);
static void MX_GPIO_Init(void);
static void MX_I2C1_Init(void);
static void MX_SPI1_Init(void);
static void MX_WWDG_Init(void);
static void MX_RTC_Init(void);
static void MX_LPUART1_UART_Init(void);
static void MX_ADC_Init(void);
/* USER CODE BEGIN PFP */

static void system_low_power_mode_config(void);
static void enter_low_power_mode();
static uint32_t adc_read_vbatt();
uint8_t PWR_PVDGetLevel(void)
{
	uint8_t temp_val = 0;
  temp_val = (uint8_t) ((PWR->CR >> 5) & 0x07);
  return temp_val;
}
/* USER CODE END PFP */

/* USER CODE BEGIN 0 */

// Last measured values
static float temperature, pressure, humidity;

// Last measured values
const uint8_t radio_health_check_state = 4;
static uint8_t radio_health_check_state_cnt = 0;

// Msg frame
static radio_msg_sensor_frame msgf =
{
	.hdr = {'L','U','6'},
};
/* USER CODE END 0 */

/**
  * @brief  The application entry point.
  * @retval int
  */
int main(void)
{
  /* MCU Configuration--------------------------------------------------------*/

  /* Reset of all peripherals, Initializes the Flash interface and the Systick. */
  HAL_Init();

  /* Configure the system clock */
  SystemClock_Config();

  /* USER CODE BEGIN SysInit */
  /* Check and handle if the system was resumed from StandBy mode */
  if(__HAL_PWR_GET_FLAG(PWR_FLAG_SB) != RESET)
  {
		/* Clear Standby flag */
		__HAL_PWR_CLEAR_FLAG(PWR_FLAG_SB);
  }
  /* USER CODE END SysInit */

  /* Initialize all configured peripherals */
  MX_GPIO_Init();
  MX_I2C1_Init();
  MX_SPI1_Init();
  MX_WWDG_Init();
  MX_RTC_Init();
  MX_LPUART1_UART_Init();
  //MX_ADC_Init(); NOT used currently
  /* USER CODE BEGIN 2 */
  dbg("LUK6");

  // Read current config from eprom
  app_settings_init();
  // Enable sensor
  sensor_init();
  // Enable radio
  radio_init();
  /* USER CODE END 2 */

  /* Infinite loop */
  /* USER CODE BEGIN WHILE */
  while (1)
  {
	/* Check if we should wake up or go to sleep again */
	if (HAL_RTCEx_BKUPRead(&hrtc, RTC_BKP_DR2) < app_settings_get_current()->update_interval)
	{
		sprintf(dbg_buf, "M_LWP_LOOP:%d, %d", HAL_RTCEx_BKUPRead(&hrtc, RTC_BKP_DR2), app_settings_get_current()->update_interval);
		dbg(dbg_buf);
		enter_low_power_mode();
		continue;
	}
	else
	{
		sprintf(dbg_buf, "M_LWP_EXIT:%d", HAL_RTCEx_BKUPRead(&hrtc, RTC_BKP_DR2));
		dbg(dbg_buf);
		// Enable sensor pin
		HAL_GPIO_WritePin(SENSOR_VDD_GPIO_Port, SENSOR_VDD_Pin, GPIO_PIN_SET);
		HAL_Delay(100);
		HAL_RTCEx_BKUPWrite(&hrtc, RTC_BKP_DR2, 0);
	}

    /* USER CODE END WHILE */

    /* USER CODE BEGIN 3 */
	/* Read data from the sensor */
	if (sensor_get_data(&temperature, &pressure, &humidity))
	{
		msgf.status = MSG_NO_ERROR;
	}
	else
	{
		dbg("M_MNO");
		msgf.status = MSG_READ_ERROR;
	}
	msgf.temperature = temperature;
	msgf.pressure = pressure;
	msgf.humidity = humidity;
	msgf.vbatt = 3300;//adc_read_vbatt();

	/* Send result data */
	radio_send(&msgf);

	/* Refresh watchdog, no more than 2[s] must expire before next refresh */
	HAL_WWDG_Refresh(&hwwdg);
	uint8_t rx_msg_wait_cnt_secs = 5; // 5 seconds
	while (rx_msg_wait_cnt_secs--)
	{
		/* Wait 1 second for incoming data from ledclock */
		HAL_Delay(1000);
		/* Refresh watchdog, no more than 2[s] must expire before next refresh */
		HAL_WWDG_Refresh(&hwwdg);
	}

	// Check if any data from ledclock came
	if (!radio_was_data_received())
	{
		radio_health_check_state_cnt++;
	}
	else
	{
		radio_health_check_state_cnt = 0;
		radio_data_received_clear();
	}

	// If any problem with radio exists, restrat it
	if (radio_health_check_state_cnt >= radio_health_check_state)
	{
		radio_restart();
	}
  }
  /* USER CODE END 3 */
}

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
/* USER CODE BEGIN 4 */

//-----------------------------------------------------------------------------
/**
  * @brief  System Low Power Configuration
  *         The system Power is configured as follow :
  *            + Regulator in LP mode
  *            + VREFINT OFF, with fast wakeup enabled
  *            + HSI as SysClk after Wake Up
  *            + No IWDG
  *            + Automatic Wakeup using RTC clocked by LSI
  * @param  None
  * @retval None
  */
static void system_low_power_mode_config(void)
{
  GPIO_InitTypeDef GPIO_InitStructure = {0};

  /* Enable Ultra low power mode */
  HAL_PWREx_EnableUltraLowPower();

  /* Enable the fast wake up from Ultra low power mode */
  HAL_PWREx_EnableFastWakeUp();

//  /* Configure all GPIO port pins in Analog Input mode (floating input trigger OFF) */
//  GPIO_InitStructure.Pin = GPIO_PIN_All;
//  GPIO_InitStructure.Mode = GPIO_MODE_ANALOG;
//  GPIO_InitStructure.Pull = GPIO_NOPULL;
//
//  HAL_GPIO_Init(GPIOA, &GPIO_InitStructure);
//  HAL_GPIO_Init(GPIOB, &GPIO_InitStructure);
//  HAL_GPIO_Init(GPIOC, &GPIO_InitStructure);
//
//  /* Disable GPIOs clock */
//  __HAL_RCC_GPIOA_CLK_DISABLE();
//  __HAL_RCC_GPIOB_CLK_DISABLE();
//  __HAL_RCC_GPIOC_CLK_DISABLE();
}

//-----------------------------------------------------------------------------
/**
  * @brief  Puts device into low power STOP mode
  *
  * @param  None
  * @retval None
  */
static void enter_low_power_mode()
{
	/* If defined, device goes into standby mode instead of stop mode */
	//#define LOW_POWER_STANBY_MODE


	/* Put radio into sleep mode */
	radio_sleep();

	/* Disable sensor */
	HAL_GPIO_WritePin(SENSOR_VDD_GPIO_Port, SENSOR_VDD_Pin, GPIO_PIN_RESET);

	/* Disable all used wakeup sources */
	HAL_RTCEx_DeactivateWakeUpTimer(&hrtc);

	/* Clear all related wakeup flags */
	__HAL_PWR_CLEAR_FLAG(PWR_FLAG_WU);

	/* Update timeout register */
	uint32_t tmp = HAL_RTCEx_BKUPRead(&hrtc, RTC_BKP_DR2);
	tmp += 20; // In seconds
	HAL_RTCEx_BKUPWrite(&hrtc, RTC_BKP_DR2, tmp);

	/* ## Setting the Wake up time ############################################*/
	/*  RTC Wakeup Interrupt Generation:
	  Wakeup Time Base = (RTC_WAKEUPCLOCK_RTCCLK_DIV /(LSE or LSI))
	  Wakeup Time = Wakeup Time Base * WakeUpCounter
	  = (RTC_WAKEUPCLOCK_RTCCLK_DIV /(LSE or LSI)) * WakeUpCounter
		==> WakeUpCounter = Wakeup Time / Wakeup Time Base

	  To configure the wake up timer to 20s the WakeUpCounter is set to 0xB4D8:
	  RTC_WAKEUPCLOCK_RTCCLK_DIV = RTCCLK_Div16 = 16
	  Wakeup Time Base = 16 /(~37.000KHz) = ~0.432 ms
	  Wakeup Time = ~20s = 0.432ms * WakeUpCounter
		==> WakeUpCounter = ~20s/0.432ms = 20000/0.432 = 46296 = 0xB4D8 */
	HAL_RTCEx_SetWakeUpTimer_IT(&hrtc, 0xB4D8, RTC_WAKEUPCLOCK_RTCCLK_DIV16);

	/* Disable SysTick. */
	//HAL_SuspendTick();
	/* Enable System Low Power */
	system_low_power_mode_config();

#ifdef LOW_POWER_STANBY_MODE
	/* Enter Low Power Standby mode */
	dbg("M_LPM_STANDBY");
	HAL_PWR_EnterSTANDBYMode();
#else
	/* Enter Low Power Stop Mode */
	dbg("M_LPM_STOP");
	HAL_PWR_EnterSTOPMode(PWR_LOWPOWERREGULATOR_ON, PWR_STOPENTRY_WFI);
#endif

	/* WakeUp happens here */
	/* Enable SysTick. */
	//HAL_ResumeTick();
	//HAL_GPIO_WritePin(SX1278_RESET_GPIO_Port, SX1278_RESET_Pin, GPIO_PIN_RESET);
	dbg("M_LPM_RUN");
}

//-----------------------------------------------------------------------------
/**
  * @brief  RTC Wake Up callback
  * @param  None
  * @retval None
  */
void HAL_RTCEx_WakeUpTimerEventCallback(RTC_HandleTypeDef *hrtc)
{
	/* Clear Wake Up Flag */
	__HAL_PWR_CLEAR_FLAG(PWR_FLAG_WU);
}

//---------------------------------------------------------------------------------
static uint32_t adc_read_vbatt()
{
	LL_ADC_EnableInternalRegulator(ADC1);
	LL_ADC_SetCommonPathInternalCh( __LL_ADC_COMMON_INSTANCE(ADC1), LL_ADC_PATH_INTERNAL_VREFINT );
	do
	{
		LL_ADC_Enable(ADC1);
	} while( !LL_ADC_IsActiveFlag_ADRDY(ADC1));

	LL_ADC_REG_StartConversion(ADC1);
	while( !LL_ADC_IsActiveFlag_EOC(ADC1));

	uint32_t adc_raw = LL_ADC_REG_ReadConversionData12(ADC1);
	do
	{
		LL_ADC_Disable(ADC1);
	} while( LL_ADC_IsEnabled(ADC1) );
	LL_ADC_DisableInternalRegulator(ADC1);
	return __LL_ADC_CALC_VREFANALOG_VOLTAGE(adc_raw, LL_ADC_RESOLUTION_12B);
}

/* USER CODE END 4 */
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
