luk6xff/led-clock/sensor-app/Core/Inc/main.h

#define SENSOR_VDD_Pin GPIO_PIN_1
#define SENSOR_VDD_GPIO_Port GPIOA
#define DBG_LPUART1_TX_Pin GPIO_PIN_2
#define DBG_LPUART1_TX_GPIO_Port GPIOA
#define SX1278_DIO0_Pin GPIO_PIN_3
#define SX1278_DIO0_GPIO_Port GPIOA
#define SX1278_DIO0_EXTI_IRQn EXTI2_3_IRQn
#define SX1278_NSS_Pin GPIO_PIN_4
#define SX1278_NSS_GPIO_Port GPIOA
#define SX1278_SCK_Pin GPIO_PIN_5
#define SX1278_SCK_GPIO_Port GPIOA
#define SX1278_MISO_Pin GPIO_PIN_6
#define SX1278_MISO_GPIO_Port GPIOA
#define SX1278_MOSI_Pin GPIO_PIN_7
#define SX1278_MOSI_GPIO_Port GPIOA
#define SX1278_RESET_Pin GPIO_PIN_1
#define SX1278_RESET_GPIO_Port GPIOB
#define SENSOR_SCL_Pin GPIO_PIN_9
#define SENSOR_SCL_GPIO_Port GPIOA
#define SENSOR_SDA_Pin GPIO_PIN_10
#define SENSOR_SDA_GPIO_Port GPIOA
