luk6xff/led-clock/esp32-app/src/Radio_ExtEnvData/radio_sensor_task.h

#pragma once

#include "Rtos/task.h"
#include "Rtos/RtosUtils.h"
#include "radio.h"

struct RadioSensorData
{
	uint32_t vbatt;
	float temperature;
	float pressure;
	float humidity;
};


struct RadioHealthStateTask
{
    TaskHandle_t task;
    rtos::Mutex mtx;
    Radio *radioHandle;
    uint32_t resetTimeoutSecs;
    uint32_t lastRadioMsgReceivedTimeMs;
};


class RadioSensorTask : public Task
{
public:
    explicit RadioSensorTask(RadioConfigData& radioCfg);
    const QueueHandle_t& getRadioSensorQ();

    static void healtStateCheckCb(void *arg);

private:
    virtual void run() override;
    bool pushRadioSensorMsg(const RadioSensorData& dt);

private:
    RadioConfigData& m_radioCfg;
    Radio m_radioSensor;
    QueueHandle_t m_radioSensorQ;
    RadioHealthStateTask m_radioHealthStateTask;
    RadioSensorData m_lastRadioMsg;
};
