luk6xff/led-clock/esp32-app/src/Display/display.cpp

#include "display.h"
#include "fonts.h"
#include "Rtos/logger.h"


//------------------------------------------------------------------------------
#define MAX_DISPLAY_ZONES 3
#define DISPLAY_ZONE_0    0
#define DISPLAY_ZONE_1    1
#define DISPLAY_ZONE_FULL 2


//------------------------------------------------------------------------------
Display::Display(const MAX72xxConfig& cfg)
    : m_mx(cfg.moduleType, cfg.max72xxCSpin, cfg.modulesNumber)
    , m_autoIntensityLevelStatus(true)
    , m_dispSpeed(50)
    , m_dispPause(0)
{
    setup();
}

//------------------------------------------------------------------------------
void Display::setup()
{
    m_mx.begin(MAX_DISPLAY_ZONES);
    m_mx.setZone(DISPLAY_ZONE_0, 0, 0);
    m_mx.setZone(DISPLAY_ZONE_1, 1, 3);
    m_mx.setZone(DISPLAY_ZONE_FULL, 0, 3);
    m_mx.setIntensity(0);
    m_mx.setFont(DISPLAY_ZONE_FULL, dig_6x8_fonts);
    m_mx.setFont(DISPLAY_ZONE_0, dig_3x5_fonts);
    m_mx.setFont(DISPLAY_ZONE_1, dig_4x8_fonts);
    m_mx.displayZoneText(DISPLAY_ZONE_FULL, m_dispFullBuf, PA_CENTER, m_dispSpeed , m_dispPause, PA_PRINT, PA_NO_EFFECT);
    m_mx.displayZoneText(DISPLAY_ZONE_0, m_dispZone0Buf, PA_LEFT, 0, 0, PA_PRINT, PA_NO_EFFECT);
    m_mx.displayZoneText(DISPLAY_ZONE_1, m_dispZone1Buf, PA_CENTER, 0, 0, PA_PRINT, PA_NO_EFFECT);
}

//------------------------------------------------------------------------------
void Display::update()
{
    m_mx.displayAnimate();
    //processAutoIntensityLevelControl(); // Called in timer task externally
}

//------------------------------------------------------------------------------
void Display::reset()
{
    m_mx.displayReset();
    // Synchronise the zone start
    m_mx.synchZoneStart();
}

//------------------------------------------------------------------------------
void Display::clear()
{
   m_mx.displayClear();
   memset(m_dispZone0Buf, 0, sizeof(m_dispZone0Buf));
   memset(m_dispZone1Buf, 0, sizeof(m_dispZone1Buf));
   memset(m_dispFullBuf, 0, sizeof(m_dispFullBuf));
}

//------------------------------------------------------------------------------
char *Display::getDispTxtBuffer()
{
    return m_dispFullBuf;
}

//------------------------------------------------------------------------------
MD_Parola* Display::getDispObject()
{
    return &m_mx;
}

//------------------------------------------------------------------------------
void Display::enableAutoIntensityLevelControl(bool enable)
{
    m_autoIntensityLevelStatus = enable;
    if (enable)
    {
        m_lightSensor.init();
    }
    else
    {
       m_lightSensor.deinit();
    }
}

//------------------------------------------------------------------------------
bool Display::isAutoIntensityEnabled()
{
    return m_autoIntensityLevelStatus;
}

//------------------------------------------------------------------------------
void Display::processAutoIntensityLevelControl()
{
    if (!isAutoIntensityEnabled())
    {
        return;
    }

    // Measure light
    const float lightVal = m_lightSensor.getIlluminance();
    logger::dbg("LightSensor - Illuminance value: %f", lightVal);

    if (lightVal == -1)
    {
        logger::err("LightSensor - Illuminance value error!");
        return;
    }

    // Last display intensty level
    static uint8_t lastIntensityLevel = 0;

    // Logarithmic level of sensor illuminance in lux [lx]
    const uint8_t level[] = {0, 1, 2, 3, 4, 5, 6, 7, 8, 9, 10, 11, 12, 13}; // 0 = low, 15 = high
    // LU_TODO Move this value to global settings
    const uint16_t maxLightIlluminance = 600;

    // Calculate linear level
    int l = (lightVal * sizeof(level)) / maxLightIlluminance;

    // Get logarithmic level
    if (l >= sizeof(level))
    {
        l = sizeof(level) - 1;
    }
    l = level[l];

    if (lastIntensityLevel != l)
    {
        lastIntensityLevel = l;
        setIntensityLevel(lastIntensityLevel);
    }
}

//------------------------------------------------------------------------------
void Display::setIntensityLevel(uint8_t level)
{
    if (level > MAX_INTENSITY)
    {
        level = MAX_INTENSITY;
    }
    m_mx.setIntensity(level);
}

//------------------------------------------------------------------------------
void Display::setDisplaySpeedValue(uint32_t speed)
{
    if (speed > 1000)
    {
        speed = 1000;
    }
    m_dispSpeed = speed;
}

//------------------------------------------------------------------------------
void Display::setDisplayPauseValue(uint32_t pause)
{
    if (pause > 1000)
    {
        pause = 1000;
    }
    m_dispPause = pause;
}

//------------------------------------------------------------------------------
bool Display::printTime(const DateTime& dt, DateTimePrintMode tpm, bool timeDots)
{
    bool status = false;

    switch(tpm)
    {
        case THM:
        {
            if (isDisplayWritable())
            {
                snprintf(getDispTxtBuffer(), sizeof(m_dispFullBuf), "%02d%c%02d", dt.hour(), (timeDots ? ':' : ' '), dt.minute());
                m_mx.displayZoneText(DISPLAY_ZONE_FULL, m_dispFullBuf, PA_CENTER, m_dispSpeed , m_dispPause, PA_PRINT, PA_NO_EFFECT);
                m_mx.setFont(dig_6x8_fonts);
                m_mx.displayReset(DISPLAY_ZONE_FULL);
                status = true;
            }
            break;
        }

        case THMS:
        {
            if (isDisplayWritable())
            {
                snprintf(m_dispZone0Buf, sizeof(m_dispZone0Buf), "%02d", dt.second());
                snprintf(m_dispZone1Buf, sizeof(m_dispZone1Buf), "%02d%c%02d", dt.hour(), (timeDots ? ':' : ' '), dt.minute());
                m_mx.displayZoneText(DISPLAY_ZONE_0, m_dispZone0Buf, PA_LEFT, 0, 0, PA_PRINT, PA_NO_EFFECT);
                m_mx.displayZoneText(DISPLAY_ZONE_1, m_dispZone1Buf, PA_CENTER, 0, 0, PA_PRINT, PA_NO_EFFECT);
                m_mx.setFont(DISPLAY_ZONE_0, dig_3x5_fonts);
                m_mx.setFont(DISPLAY_ZONE_1, dig_4x8_fonts);
                m_mx.displayReset(DISPLAY_ZONE_0);
                m_mx.displayReset(DISPLAY_ZONE_1);
                status = true;
            }
            break;
        }

        case DWYMD:
        {
            if (isDisplayWritable())
            {
                // Convert weekday to extended - ascii;
                String wd = utf8Ascii(SystemTime::weekdayToStr(dt));
                snprintf(getDispTxtBuffer(), sizeof(m_dispFullBuf), "%s %s", wd.c_str(), SystemTime::dateToStr(dt));
                m_mx.displayZoneText(DISPLAY_ZONE_FULL, m_dispFullBuf, PA_CENTER, m_dispSpeed , m_dispPause, PA_SCROLL_LEFT, PA_SCROLL_LEFT);
                m_mx.setFont(NULL);
                m_mx.displayReset(DISPLAY_ZONE_FULL);
                status = true;
            }
            break;
        }

        default:
        {
            logger::err("Invalid Print time mode");
            break;
        }
    }
    return status;
}

//------------------------------------------------------------------------------
bool Display::printMsg(const char *msg, const size_t msgSize)
{
    bool status = false;

    if (!msg)
    {
        logger::dbg("Invalid msg to be displayed");
    }
    else
    {
        if (isDisplayWritable())
        {
            String utfMsg = utf8Ascii(msg);
            snprintf(getDispTxtBuffer(), sizeof(m_dispFullBuf), "%s", utfMsg.c_str());
            m_mx.displayZoneText(DISPLAY_ZONE_FULL, m_dispFullBuf, PA_CENTER, m_dispSpeed , m_dispPause, PA_SCROLL_LEFT, PA_SCROLL_LEFT);
            m_mx.displayReset(DISPLAY_ZONE_FULL);
            m_mx.setFont(NULL);
            status = true;
        }
    }

    return status;
}

//------------------------------------------------------------------------------
String Display::utf8Ascii(const char *s)
{

    uint8_t prev_c = '\0';
    String cp;
    //logger::dbg("Converting: %s from UTF-8 to Extended ASCII...", s);

    while (*s != '\0')
    {
        const uint8_t tmp_c = *s++;
        uint8_t c = '\0';

        if (tmp_c < 0x7f)   // Standard ASCII-set 0..0x7F, no conversion
        {
            prev_c = '\0';
            c = tmp_c;
        }
        else
        {
            switch (prev_c)  // Conversion depending on preceding UTF8-character
            {
                case 0xC2: c = tmp_c;  break;
                case 0xC3: c = tmp_c | 0xC0;  break;
                case 0xC4: c = tmp_c; break;
                case 0xC5: c = tmp_c | 0xD0;  break;
                case 0x82: if (tmp_c == 0xAC) c = 0x80; // Euro symbol special case
            }
            prev_c = tmp_c;   // save last char
            //logger::dbg("Converted:0x%x[%d] to:0x%x[%d]", tmp_c, tmp_c, c, c);
        }

        if (c != '\0')
        {
            cp += (char)c;
        }
    }
    cp += '\0';   // terminate the new string
    //logger::dbg(">>>> CP: %s", cp.c_str());
    return cp;
}

//------------------------------------------------------------------------------
bool Display::isDisplayWritable()
{
    if (getDispObject()->getZoneStatus(DISPLAY_ZONE_FULL) &&
        getDispObject()->getZoneStatus(DISPLAY_ZONE_0) &&
        getDispObject()->getZoneStatus(DISPLAY_ZONE_1))
    {
        return true;
    }
    return false;
}

//------------------------------------------------------------------------------
