luk6xff/led-clock/esp32-app/src/Clock/system_time_settings.h

#pragma once

#include <ArduinoJson.h>
#include <Timezone.h>
#include "App/utils.h"
#include <cstdint>
#include <string>
#include <stdexcept>


#define TIME_CFG_VAL_TZ_NUM             "time-timezone-num"
#define TIME_CFG_VAL_TZ_1               "time-timezone-1"
#define TIME_CFG_VAL_TZ_2               "time-timezone-2"
#define TIME_CFG_VAL_NTP_ON             "time-ntp-enable"
#define TIME_CFG_VAL_NTP_TIME_OFFSET    "time-ntp-time-offset"
#define TIME_CFG_VAL_NTP_SYNC_INT       "time-ntp-sync-interval"
#define TIME_CFG_VAL_NTP_SERVER_1       "time-ntp-server-1"
#define TIME_CFG_VAL_NTP_SERVER_2       "time-ntp-server-2"
#define TIME_CFG_VAL_NTP_SERVER_3       "time-ntp-server-3"

struct NtpSettings
{
    #define NTP_SERVER_NAME_MAXLEN 32

    NtpSettings()
        : ntpEnabled(true)
        , timeOffset(0)
        , updateInterval(1000*3600) // 1h (in miliseconds)
    {
        memcpy(poolServerNames[0], "time.google.com", NTP_SERVER_NAME_MAXLEN);
        memcpy(poolServerNames[1], "pl.pool.ntp.org", NTP_SERVER_NAME_MAXLEN);
        memcpy(poolServerNames[2], "pool.ntp.org",    NTP_SERVER_NAME_MAXLEN);
    }

    NtpSettings(bool enabled, int32_t tO, uint32_t uI, const char *server0Name,
                const char *server1Name=nullptr, const char *server2Name=nullptr)
        : ntpEnabled(enabled)
        , timeOffset(tO)
        , updateInterval(uI)
    {
        memset(poolServerNames[0], 0, NTP_SERVER_NAME_MAXLEN);
        memset(poolServerNames[1], 0, NTP_SERVER_NAME_MAXLEN);
        memset(poolServerNames[2], 0, NTP_SERVER_NAME_MAXLEN);
        if (server0Name)
        {
            memcpy(poolServerNames[0], server0Name, NTP_SERVER_NAME_MAXLEN);
        }
        if (server1Name)
        {
            memcpy(poolServerNames[1], server1Name, NTP_SERVER_NAME_MAXLEN);
        }
        if (server2Name)
        {
            memcpy(poolServerNames[2], server2Name, NTP_SERVER_NAME_MAXLEN);
        }
    }

    NtpSettings(const NtpSettings& other)
        : ntpEnabled(true)
        , timeOffset(other.timeOffset)
        , updateInterval(other.updateInterval)
    {
        memcpy(poolServerNames[0], other.poolServerNames[0], NTP_SERVER_NAME_MAXLEN);
        memcpy(poolServerNames[1], other.poolServerNames[1], NTP_SERVER_NAME_MAXLEN);
        memcpy(poolServerNames[2], other.poolServerNames[2], NTP_SERVER_NAME_MAXLEN);
    }

    NtpSettings& operator=(const NtpSettings& other)
    {
        timeOffset = other.timeOffset;
        updateInterval = other.updateInterval;
        memcpy(this->poolServerNames[0], other.poolServerNames[0], NTP_SERVER_NAME_MAXLEN);
        memcpy(this->poolServerNames[1], other.poolServerNames[1], NTP_SERVER_NAME_MAXLEN);
        memcpy(this->poolServerNames[2], other.poolServerNames[2], NTP_SERVER_NAME_MAXLEN);
        return *this;
    }

    String toStr()
    {
        const String colon = ":";
        const String comma =", ";
        return String("NtpCfg")+colon+comma + \
                String(TIME_CFG_VAL_NTP_ON)+colon+String(ntpEnabled)+comma + \
                String(TIME_CFG_VAL_NTP_TIME_OFFSET)+colon+String(timeOffset)+comma  + \
                String(TIME_CFG_VAL_NTP_SYNC_INT)+colon+String(updateInterval)+comma  + \
                String(TIME_CFG_VAL_NTP_SERVER_1)+colon+String(poolServerNames[0])+comma + \
                String(TIME_CFG_VAL_NTP_SERVER_2)+colon+String(poolServerNames[1])+comma + \
                String(TIME_CFG_VAL_NTP_SERVER_3)+colon+String(poolServerNames[2]);
    }

    uint32_t ntpEnabled;
    int32_t timeOffset;      // in [min]
    uint32_t updateInterval; // in [ms]
    char poolServerNames[3][NTP_SERVER_NAME_MAXLEN];
};


/**
 * @brief System Time settings
 */
struct SystemTimeSettings
{
    std::string toJson()
    {
        StaticJsonDocument<512+128> doc;
        std::string json;
        JsonArray arr = doc.createNestedArray(TIME_CFG_KEY);
        JsonObject obj = arr.createNestedObject();
        obj = arr.createNestedObject();
        obj[TIME_CFG_VAL_TZ_NUM] = timezoneNum;
        obj = arr.createNestedObject();
        const String tz1 = timeChangeRuleToServerStr(stdStart);
        obj[TIME_CFG_VAL_TZ_1] = tz1.c_str();
        obj = arr.createNestedObject();
        const String tz2 = timeChangeRuleToServerStr(dstStart);
        obj[TIME_CFG_VAL_TZ_2] = tz2.c_str();
        obj = arr.createNestedObject();
        obj[TIME_CFG_VAL_NTP_ON] = ntp.ntpEnabled;
        obj = arr.createNestedObject();
        obj[TIME_CFG_VAL_NTP_TIME_OFFSET] = ntp.timeOffset;
        obj = arr.createNestedObject();
        obj[TIME_CFG_VAL_NTP_SYNC_INT] = ntp.updateInterval / 1000 / 60; // Convert from ms to minutes on server
        serializeJson(doc, json);
        return json;
    }

    void fromJson(const JsonObject& json)
    {
        JsonArray arr = json[TIME_CFG_KEY].as<JsonArray>();
        for (const auto& v : arr)
        {
            if (v[TIME_CFG_VAL_TZ_NUM])
            {
                timezoneNum = v[TIME_CFG_VAL_TZ_NUM].as<uint32_t>();
                if (timezoneNum == 0 || timezoneNum > 2)
                {
                    timezoneNum = 1;
                }
            }
            else if (v[TIME_CFG_VAL_TZ_1])
            {
                std::string tz(v[TIME_CFG_VAL_TZ_1].as<const char*>());
                // Validate
                TimeChangeRule tzRule;
                if (validateAndParseTzCfgStr(tz, tzRule))
                {
                    stdStart = tzRule;
                }
                else
                {
                    utils::err("Invalid settings for Timezone1");
                }
            }
            else if (v[TIME_CFG_VAL_TZ_2])
            {
                std::string tz(v[TIME_CFG_VAL_TZ_2].as<const char*>());
                // Validate
                TimeChangeRule tzRule;
                if (validateAndParseTzCfgStr(tz, tzRule))
                {
                    dstStart = tzRule;
                }
                else
                {
                    utils::err("Invalid settings for Timezone2");
                }
            }
            else if (v[TIME_CFG_VAL_NTP_ON])
            {
                ntp.ntpEnabled = v[TIME_CFG_VAL_NTP_ON].as<uint32_t>();
            }
            else if (v[TIME_CFG_VAL_NTP_TIME_OFFSET])
            {
                ntp.timeOffset = v[TIME_CFG_VAL_NTP_TIME_OFFSET].as<int32_t>();
                if (ntp.timeOffset < -720 || ntp.timeOffset > 720)
                {
                    ntp.timeOffset = 0;
                }
            }
            else if (v[TIME_CFG_VAL_NTP_SYNC_INT])
            {
                ntp.updateInterval = v[TIME_CFG_VAL_NTP_SYNC_INT].as<uint32_t>();
                if (ntp.updateInterval == 0)
                {
                    ntp.updateInterval = 1;
                }
                // Convert from minutes on server to ms
                ntp.updateInterval = ntp.updateInterval * 60 * 1000;
            }
        }
    }

    bool validateAndParseTzCfgStr(const std::string& s, TimeChangeRule& tz)
    {
        // Validate
        std::string delim = "|";
        if (s.size() == 0)
        {
            return false;
        }
        if (s[0] != '[' || s[s.size()-1] != ']')
        {
            return false;
        }

        auto start = 1U;
        auto end = s.find(delim);
        std::string str = s;
        str[0] = '|';
        str[str.size()-1] = '|';
        std::vector<std::string> data;
        while (end != std::string::npos)
        {
            data.push_back(str.substr(start, end-start));
            start = end + delim.length();
            end = str.find(delim, start);
        }

        if (data.size() != 6)
        {
            utils::err("Not enough data in TZ cfg: %d", data.size());
            utils::dbg("TZ cfg:");
            for (auto& d : data)
            {
                utils::dbg("%s", d.c_str());
            }
            return false;
        }

        // Check values
        const int week = String(data[1].c_str()).toInt();
        if (week < Last || week > Fourth)
        {
            return false;
        }
        const int dow = String(data[2].c_str()).toInt();
        if (dow < Sun || dow > Sat)
        {
            return false;
        }
        const int month = String(data[3].c_str()).toInt();
        if (month < Jan || month > Dec)
        {
            return false;
        }
        const int hour = String(data[4].c_str()).toInt();
        if (hour < 0 || hour > 23)
        {
            return false;
        }
        const int offset = String(data[5].c_str()).toInt();
        if (offset < -720 || offset > 720)
        {
            return false;
        }

        // Set values in memory
        memcpy(tz.abbrev, data[0].c_str(), 6);
        tz.week = week;
        tz.dow = dow;
        tz.month = month;
        tz.hour = hour;
        tz.offset = offset;
        return true;
    }

    String timeChangeRuleToServerStr(const TimeChangeRule& tz)
    {
        String s;
        s += '[';
        s += String(tz.abbrev) + '|';
        s += String(tz.week) + '|';
        s += String(tz.dow) + '|';
        s += String(tz.month) + '|';
        s += String(tz.hour) + '|';
        s += String(tz.offset) + ']';
        return s;
    }

    String toStr()
    {
        const String colon = ":";
        const String comma =", ";
        return String(TIME_CFG_KEY)+colon+comma + \
                String(TIME_CFG_VAL_TZ_NUM)+colon+String(timezoneNum)+comma + \
                String(TIME_CFG_VAL_TZ_1)+colon+String(stdStart.toStr())+comma  + \
                String(TIME_CFG_VAL_TZ_2)+colon+String(dstStart.toStr())+comma  + \
                ntp.toStr();
    }


    uint32_t timezoneNum;
    TimeChangeRule stdStart; // CET  - Central European Time (UTC+1)
    TimeChangeRule dstStart; // CEST - Central European daylight saving time (summer UTC+2)
    NtpSettings ntp;
};
