luk6xff/led-clock/esp32-app/src/Clock/ntp_task.cpp

#include "ntp_task.h"
#include "system_time.h"
#include "Rtos/RtosUtils.h"
#include "Wifi/wifi_task.h"
#include "Rtos/logger.h"
#include "App/app_context.h"

//------------------------------------------------------------------------------
#define NTP_TASK_STACK_SIZE (4096)
#define NTP_TASK_PRIORITY      (3)

#define MODULE_NAME "[NTP]"

//------------------------------------------------------------------------------
NtpTask::NtpTask(TimeConfigData& ntpCfg, const EventGroupHandle_t& wifiEvtHandle)
    : Task("NtpTask", NTP_TASK_STACK_SIZE, NTP_TASK_PRIORITY, CONFIG_ARDUINO_RUNNING_CORE)
    , m_ntpCfg(ntpCfg)
    , m_wifiEvtHandle(wifiEvtHandle)
{
    m_ntpTimeQ = xQueueCreate(1, sizeof(DateTime));
    if (!m_ntpTimeQ)
    {
        logger::err("%s m_ntpTimeQ has not been created!.", MODULE_NAME);
    }
}

//------------------------------------------------------------------------------
const QueueHandle_t& NtpTask::getNtpTimeQ()
{
    return m_ntpTimeQ;
}

//------------------------------------------------------------------------------
void NtpTask::run()
{
    TickType_t sleepTime = (10000 / portTICK_PERIOD_MS);
    WifiTask::WifiEvent lastWifiState = WifiTask::WIFI_INVALID;
    Ntp ntp(m_ntpCfg);
    DateTime dt;

    if (!m_wifiEvtHandle)
    {
        kill();
    }

    for(;;)
    {
        // Disable if OTA Update
        if (AppCtx.appStatus() & AppStatusType::OTA_UPDATE_RUNNING)
        {
            vTaskDelay(sleepTime);
            continue;
        }

        const EventBits_t wifiEv = xEventGroupWaitBits(
                                    m_wifiEvtHandle,// WIFI Event group
                                    WifiTask::WIFI_CONNECTED |
                                    WifiTask::WIFI_DISCONNECTED, // bits to wait for
                                    pdFALSE,        // no clear
                                    pdFALSE,        // wait for all bits
                                    portMAX_DELAY); // timeout

        if ((wifiEv & WifiTask::WIFI_CONNECTED) != 0)
        {
            lastWifiState = WifiTask::WIFI_CONNECTED;
        }
        else if ((wifiEv & WifiTask::WIFI_DISCONNECTED) != 0)
        {
            lastWifiState = WifiTask::WIFI_DISCONNECTED;
        }

        // Or just this :D
        // if(!WiFi.isConnected())
        // {
        //     vTaskDelay(sleepTime);
        //     continue;
        // }

        if (m_ntpCfg.ntpEnabled && lastWifiState == WifiTask::WIFI_CONNECTED)
        {
            if (ntp.updateTime())
            {
                DateTime dt(ntp.getCurrentTime());
                logger::dbg("%s UTC:%s", MODULE_NAME, dt.timestamp().c_str());
                // Update in Systime clock task
                if (m_ntpTimeQ)
                {
                    xQueueOverwrite(m_ntpTimeQ, &dt);
                }
                sleepTime = (m_ntpCfg.ntpUpdateInterval / portTICK_PERIOD_MS);
            }
        }

        vTaskDelay(sleepTime);
    }
}

//------------------------------------------------------------------------------
