luk6xff/led-clock/esp32-app/src/Clock/ntp.cpp

#include "ntp.h"
#include "Rtos/logger.h"

//------------------------------------------------------------------------------
Ntp::Ntp(const TimeConfigData& config)
    : m_config(config)
    , m_ntpClient(m_ntpUDP, m_config.ntpPoolServerNames[0],
                    m_config.ntpTimeOffset, m_config.ntpUpdateInterval)
{

}

//------------------------------------------------------------------------------
bool Ntp::updateTime()
{
    return m_ntpClient.update();
}

//------------------------------------------------------------------------------
uint64_t Ntp::getCurrentTime()
{
    return m_ntpClient.getEpochTime();
}

//------------------------------------------------------------------------------
String Ntp::getCurrentTimeString() const
{
    return m_ntpClient.getFormattedTime();
}

//------------------------------------------------------------------------------
