luk6xff/led-clock/esp32-app/src/Rtos/log.cpp

#include "log.h"

#define DBG_BAUDRATE 115200
#define DBG_VERBOSITY_LEVEL DBG_VERBOSE

//------------------------------------------------------------------------------
void log::init()
{
    Serial.begin(DBG_BAUDRATE);
    Debug.setDebugOutputStream(&Serial);
    Debug.setDebugLevel(DBG_VERBOSITY_LEVEL);
    Debug.timestampOff();
    log::inf(">>> LED-CLOCK by luk6xff 2020 <<<\r\n");
}

//------------------------------------------------------------------------------
