luk6xff/led-clock/esp32-app/src/App/app_vars.h

/**
 * @brief App variables, modified by external script
 *
 * @author Lukasz Uszko - luk6xff
 * @date   2020-11-20
 */

// Define the app version number
#define APP_VERSION "0.1.0"

#define APP_DATE_LAST_MODIFIED "Thu, 07 Jul 2022 18:45:10 GMT"
