luk6xff/led-clock/esp32-app/src/App/rtos_common.cpp

#include "rtos_common.h"

using namespace rtos;


//------------------------------------------------------------------------------
Mutex::Mutex()
    : m_handle(nullptr)
{
    m_handle = xSemaphoreCreateMutex();
}

//------------------------------------------------------------------------------
Mutex::~Mutex()
{
    unlock();
    reset();
}

//------------------------------------------------------------------------------
void Mutex::lock()
{
    if (m_handle)
    {
        xSemaphoreTake(m_handle, portMAX_DELAY);
    }
}

//------------------------------------------------------------------------------
void Mutex::unlock()
{
    if (m_handle)
    {
        xSemaphoreGive(m_handle);
    }
}

//------------------------------------------------------------------------------
void Mutex::reset()
{
    m_handle = nullptr;
}


//------------------------------------------------------------------------------
/**
 * @brief TwoWire0 global mutex
 */
rtos::Mutex g_i2c0Mutex;

//------------------------------------------------------------------------------
