luk6xff/led-clock/(commit log)

2020-07-07 BOM first draft
2020-07-07 esp32 skeleton
2020-07-07 esp32 dev link
2020-07-29 MAX72xx driver lib tests
2020-08-06 Not used LEDMatrixLibrary Removed
2020-08-06 light sensor
2020-08-11 sensor app created, LORA communication done
    [sensor-app Debug.cfg]
2020-08-31 msg frame design
2020-08-31 recv msg from sensor board done
2020-10-18 Wire sync issue - fix
    [clock_task.cpp, display.cpp, display_task.cpp, light_sensor.cpp, system_time.cpp]
2020-10-19 Disable light sensor - issue to be fixed
    [clock_task.cpp, display.cpp, display.h, main.cpp]
2020-10-24 Sensor app rework
2020-10-25 Stop mode on sensor done
2020-10-25 Stop mode on STM32 done
2020-10-25 Stop mode on sensor - works
2020-10-25 Radio Sensor task done
2020-10-25 Sensor task queue added
2020-10-26 Sensor app - WWDG enabled
2020-10-26 Sensor app - LPUART1
2020-10-26 Sensor app - ADC VBATT draft
2020-11-16 Cfg - skip store if no change
    [display_task.cpp]
2020-11-17 Fix for own data format
    [main.cpp, system_time_settings.h]
2020-11-18 Fix logo layout issue
    [app.cpp, app.h]
2020-11-19 Fix for servers reinint during reconnection
    [clock_task.cpp, webserver.cpp, webserver.h]
2020-11-20 App settings, more fixes
    [app.cpp, app_shared.cpp, app_shared.h, display.cpp, display.h, display_task.cpp, i18n.cpp]
2020-11-20 Light sensor fixed and enabled
    [app.cpp, app.h, display.cpp, display.h, display_task.cpp, display_task.h, hw_config.h]
2020-11-23 Lora lib more fixes
    [app.h, clock_task.cpp, main.cpp, radio.cpp, radio.h, radio_sensor_task.cpp, tests.cpp]
2020-11-24 lora on sensor board working
2020-11-24 Bare metal lora driver finished
2020-11-27 LedClock version 0.1.0 done
2020-12-05 radio-sensor schematic done
    [ledclock-sensor.kicad_pcb, ledclock-sensor.sch]
2020-12-05 Temp display resolution fixed to 1 decimal
    [radio_sensor_task.cpp]
2020-12-21 Fix for humidity readout in BME280 lib
    [main.c, sensor.c]
2021-01-15 Lora sensor app port to my Lora library
2021-01-16 Fix for repeating last radio messages
    [radio_sensor_task.cpp]
2021-07-08 Internal temperature readout defaults
2021-07-08 Fix for print time not a msg range
    [app_vars.h, display_task.cpp, system_time.cpp, system_time.h]
2021-07-13 LedClock case final version
    [LedClock-Back.stl, LedClock-Front.stl]
2021-07-14 Case stl files update
    [LedClock-Back.stl, LedClock-Front.stl]
2021-07-15 LedClock Version 0.0.1 released
2021-07-16 pictures update
    [led-clock.fzz]
2021-07-16 BOM update
2021-07-16 EXT sensor status modified
2021-07-21 sensor-app README update
2021-07-21 sensor app solution cleanup
2021-07-23 Display clear method fix
    [app_vars.h, display.cpp]
