luk6xff/led-clock/docs/pics/dev-sensor5.jpg

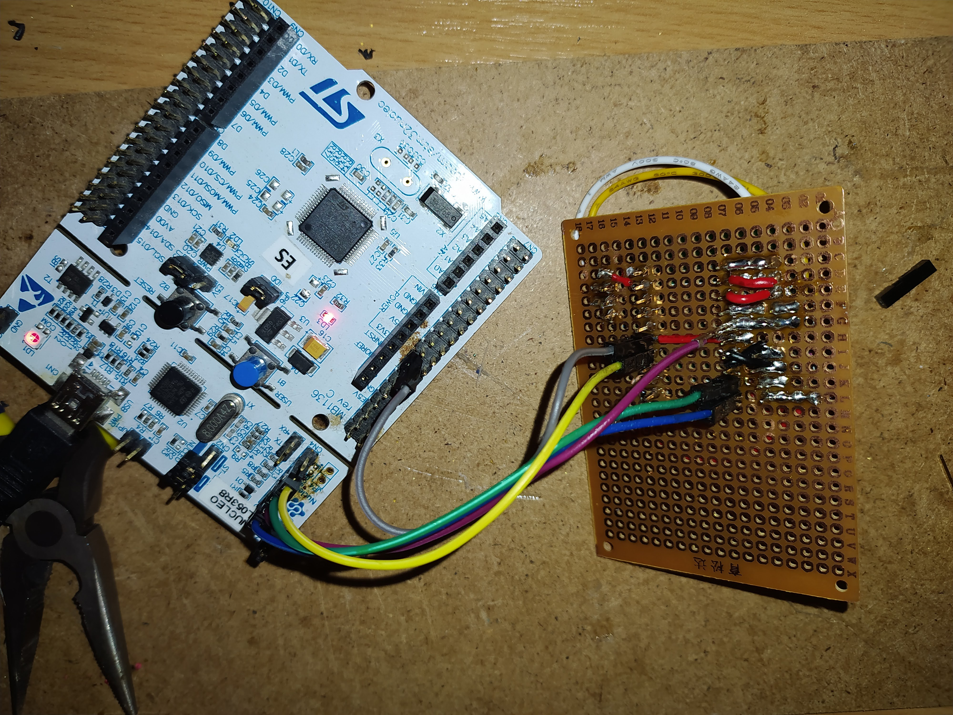
docs/pics/dev-sensor5.jpg
