luk6xff/led-clock/docs/pics/dev-sensor6.jpg

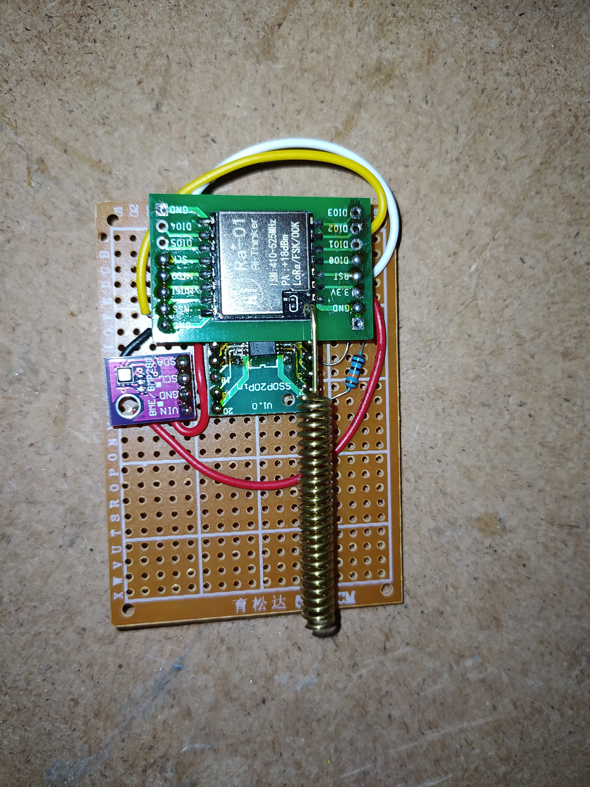
docs/pics/dev-sensor6.jpg
