luk6xff/led-clock/docs/pics/dev-sensor7.jpg

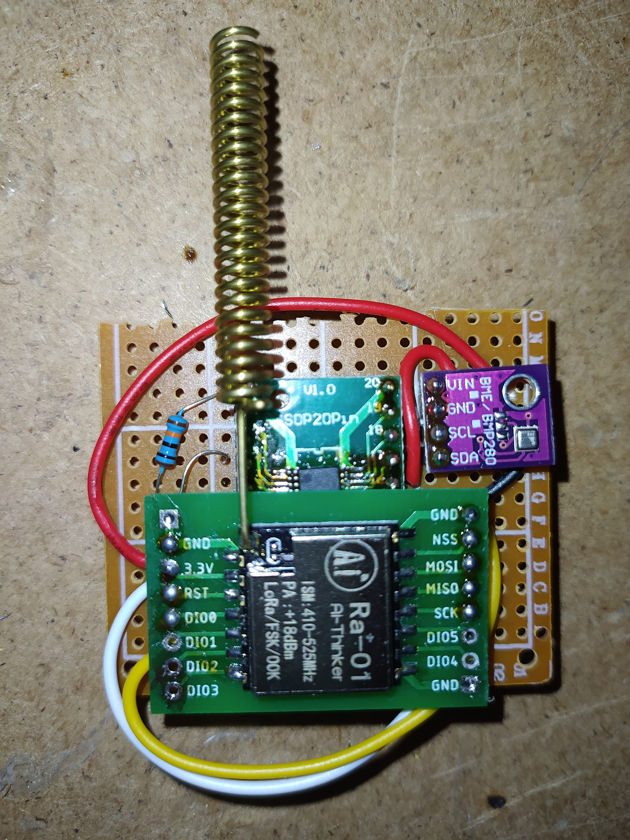
[picture p5: docs/pics/dev-sensor7.jpg]
docs/pics/dev-sensor7.jpg
